JakubPajak/arduino_robot/report/report.tex

\documentclass{report}
\usepackage{tocloft}
\usepackage{geometry}
\usepackage{graphicx}
\usepackage{caption}
\usepackage[T1]{fontenc}
\usepackage[utf8]{inputenc}
\usepackage[polish]{babel}
\usepackage{float}
\usepackage{listings}
\usepackage{xcolor}
\usepackage{array}
\usepackage{enumitem}
\usepackage[style=alphabetic]{biblatex}
\usepackage{multirow}
\usepackage{hyperref}
\addbibresource{bibliography.bib}

\geometry{
    a4paper,
    left=2.5cm,
    right=2.5cm,
    top=2.5cm,
    bottom=2.5cm,
}

\lstset{
    language=Matlab, 
    basicstyle=\footnotesize\ttfamily,
    keywordstyle=\color{blue},
    commentstyle=\color{green},
    stringstyle=\color{red},
    numbers=left,
    numberstyle=\tiny\color{gray},
    stepnumber=1,
    numbersep=5pt,
    backgroundcolor=\color{lightgray},
    frame=single,
    tabsize=2,
    captionpos=b,
    breaklines=true
}

\setcounter{tocdepth}{3}
\setlength{\cftbeforechapskip}{15pt} 
\setlength{\cftbeforesecskip}{8pt} 
\setlength{\cftbeforesubsecskip}{5pt} 
\setlength{\cftbeforesubsubsecskip}{5pt}

\renewcommand\thesection{\arabic{section}.}
\renewcommand\thesubsection{\thesection\arabic{subsection}.}
\renewcommand\thesubsubsection{\thesubsection\arabic{subsubsection}.}
\setcounter{secnumdepth}{3}

\begin{document}

\begin{titlepage}
    \centering
    \vspace*{1cm}
    \begin{figure}
        \centering 
        
    \end{figure}
    \Huge
    Zajęcia Projektowe
    \par
    \textbf{Podstawy Robotyki}
    
    \vspace*{1cm}

    \vspace{0.5cm}
    \LARGE \textit{Platforma jeżdżąca automatycznie utrzymująca odległość od ściany}
    
    \vspace{1.5cm}
    
    \textbf{Autorzy:} 
    \par
    Jakub Pająk 
    \par
    Łukasz Grabarski
    \par 
    Krzysztof Grądek
    \par 
    Piotr Legień
    \par
    Bartosz Wuwer
    \vspace*{1.5cm}
    \par AiR Grupa 5TI
    
    \vfill
    
    \Large 30.05.2024
    
\end{titlepage}

\newpage

\tableofcontents

\newpage

\section{\LARGE Wprowadzenie}
\subsection{\Large Cel projektu}
Celem niniejszego projektu jest opracowanie mobilnej platformy robotycznej, zdolnej do automatycznego utrzymywania określonej odległości od ściany. Platforma ta bazować będzie na mikrokontrolerze Arduino oraz laserowych czujnikach odległości typu ToF (ang. Time of Flight). Projekt ma na celu zbadanie i rozwinięcie zaawansowanych algorytmów sterowania i nawigacji, które umożliwią precyzyjne śledzenie ścian w zmiennych warunkach środowiskowych. Dodatkowym celem jest stworzenie wszechstronnego rozwiązania, które można łatwo dostosować do różnych zastosowań, takich jak roboty sprzątające, inspekcyjne czy systemy autonomiczne w logistyce.

\subsection{\Large Założenia wstępne}
Robot został zaprojektowany w oparciu o mikrokontroler Arduino Uno R4, wybrany ze względu na wbudowany moduł Bluetooth LE (LE - Low Energy), co umożliwiło zdalne monitorowanie i kontrolę. Silniki zastosowane w projekcie są wyposażone w enkodery, co zapewni precyzyjne sterowanie. Czujniki odległości zostały podłączone do mikrokontrolera za pomocą magistrali I2C. Ze względu na planowaną liczbę czujników (osiem), połączenie ich innymi metodami nie byłoby możliwe.

Zasilanie platformy jest wystarczające do obsługi co najmniej jednego mikrokontrolera oraz czterech silników. Optymalnym rozwiązaniem jest zastosowanie czterech ogniw litowo-jonowych połączonych w konfiguracji 2S2P, co zapewni odpowiednią wydajność energetyczną. Dodatkowo, konieczne jest zastosowanie układu zarządzania baterią BMS (ang. Battery Management System), który zabezpieczy ogniwa przed nadmiernym rozładowaniem i przeładowaniem.

Całość konstrukcji została zamknięta w obudowie wykonanej techniką druku 3D. Obudowa jest podzielona na dwie główne sekcje: dolną, w której zostaną umieszczone silniki oraz ogniwa wraz z układem BMS, oraz górną, zawierającą płytkę stykową, mikrokontroler oraz czujniki. Taka konstrukcja zapewnia łatwy dostęp do kluczowych komponentów i umożliwi ich sprawną wymianę w razie potrzeby.

% Początkowo plan realizacji projektu zakładał stworzenie aplikacji, która byłaby odpowiedzialna za zdalne sterowanie robotem poprzez moduł BLE (ang. Bluetooth Low Energy). W wyniku późniejszych konsultacji plan uległ zmianie jednak aplikacja zostanie wykorzystana jako wsparcie dla automatycznego trybu robota.

\section{\LARGE Realizacja projektu}
Projekt był realizowany etapami, jednak nie został zastosowany szczegółowy harmonogram. 
Przybliżone etapy rozwoju projektu:
\begin{enumerate}
    \item Napisanie aplikacji w wersji dedykowanej systemowi Android w języku Dart,
    \item Realizacja prostego skryptu w Arduino IDE w celu weryfikacji połączenia BLE z mikrokontrolerem,
    \item Wykonanie projektu obudowy robota w 3D oraz przygotowanie do druku,
    \item Wykonanie prostego kodu w celu weryfikacji poprawności podłączenia silników do sterownika,
    \item Podłączenie oraz weryfikacja poprawności działania laserowych czujników odległości,
    \item Montaż silników wewnątrz dolnej komory obudowy,
    \item Montaż ogniw wraz z układem BMS,
    \item Integracja czujników z silnikami oraz implementacja logiki sterowania,
    \item Testy poprawności działania algorytmu sterującego.
\end{enumerate}

\subsection{\Large Panel sterowania w aplikacji}
Podczas analizy możliwych rozwiązań problemu zdalnego sterowania robotem wybór padł na wykonanie aplikacji mobilnej oraz przesyłanie odpowiednich komend za pomocą protokołu BLE. Protokół BLE jest pewnym szczególnym przypadkiem ogólnego protokołu Bluetooth, jest on szczególnie często spotykany w przypadku mniej zaawansowanych mikrokontrolerów takich jak Arduino Uno R4. Dzięki odpowiedniej architekturze protokół ten pozwala na bardziej efektywne zarządzanie pobieraną energią, jednocześnie zachowując niezbędne funkcjonalności. 

Przez wzgląd na wcześniej nabyte umiejętności tworzenia aplikacji za pomocą języka Dart przez jednego z członków sekcji, prace nad projektem rozpoczęto od implementacji podstawowej wersji aplikacji realizującej proste przesyłanie informacji w postaci całkowitoliczbowej w celu późniejszej interpretacji otrzymanych danych w środowisku Arduino. 

Przez wzgląd na tematykę projektu implementacja aplikacji nie zostanie w poniższym raporcie szczegółowo omówiona. Zostanie przedstawiony podstawowy interfejs graficzny oraz zasada działania kluczowych funkcji, takich jak połączenie lub realizacja przesyłu danych. Autor uważa, iż pewne wyszczególnienie części metod oraz zastosowanych bibliotek może pomóc niektórym osobom w prostszym znalezieniu informacji na temat poprawnie działającego połączenia z mikrokontrolerem Arduino poprzez Bluetooth.

\subsection{\large Interfejs użytkownika aplikacji }
% --------------------------------------------------------
% Autor: Jakub Pajak
%
% TODO: Opisać Interfejs użytkownika oraz co robią poszczególne funkcje, jak działa aplikacja na poziomie ideowym
%
% Status: 100%
% --------------------------------------------------------

Interfejs użytkownika został zaprojektowany w celu umożliwienia podstawowej kontroli nad robotem. Z tego względu, nie poświęcono mu znacznej ilości czasu na poprawę estetyki.

Po uruchomieniu aplikacji użytkownik trafia na ekran początkowy (ang. Home), przedstawiony na Rysunku \ref{fig:home_screen}. Ekran ten zawiera cztery wyróżnione obszary, każdy z których pełni określoną funkcję. Pierwsza sekcja ma na celu wprowadzenie nowego użytkownika w sposób bezpiecznego i poprawnego korzystania oraz sterowania robotem.

Druga sekcja prowadzi do ustawień wyglądu aplikacji, gdzie użytkownik może dostosować kolorystykę i inne elementy graficzne interfejsu.

\begin{figure}[H]
    \centering
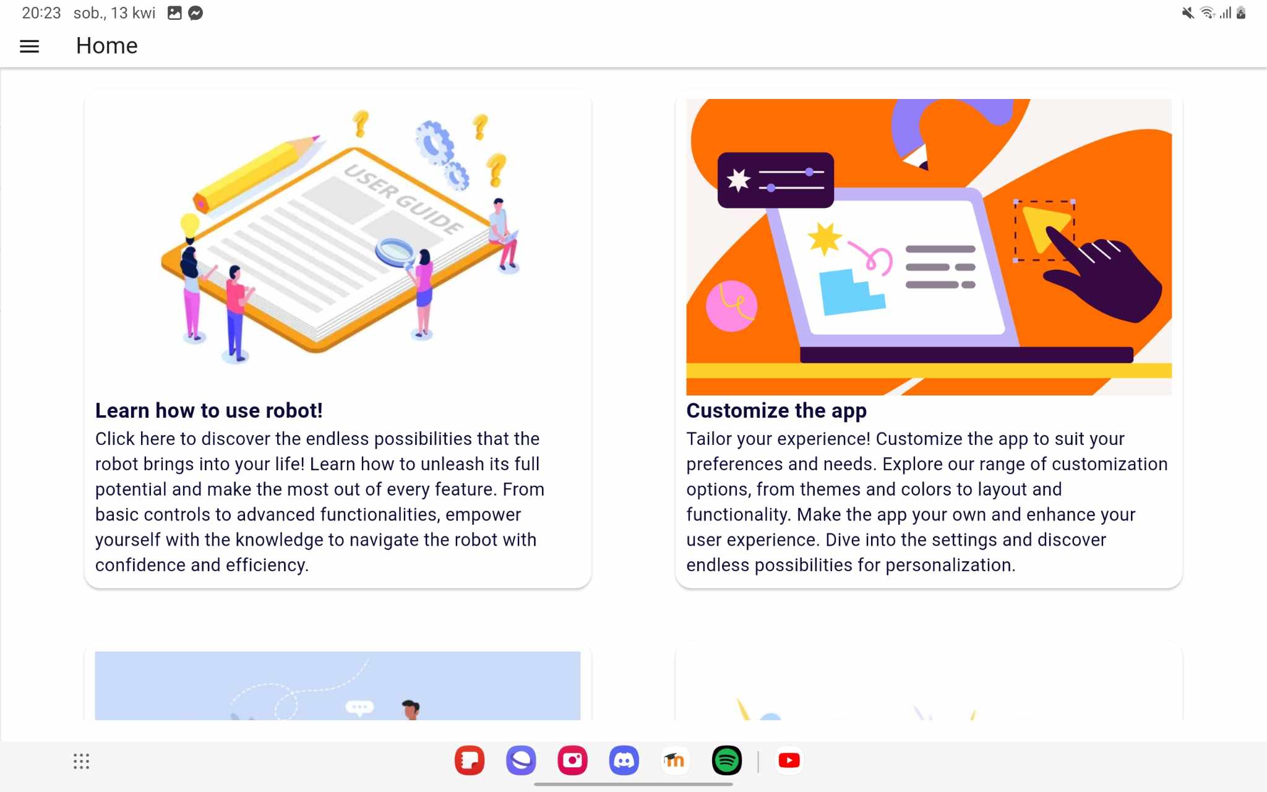
[picture p1: report/src/app/home.jpg]
    
    \caption{Ekran początkowy aplikacji}
    \label{fig:home_screen}
\end{figure}

Trzecia i czwarta sekcja dotyczą genezy projektu oraz zespołu, który stworzył robota i aplikację. Ponadto, umożliwiają one użytkownikom przesyłanie opinii, co pozwala na wprowadzenie przyszłych aktualizacji mających na celu poprawę jakości korzystania z aplikacji.

\begin{figure}[H]
    \centering
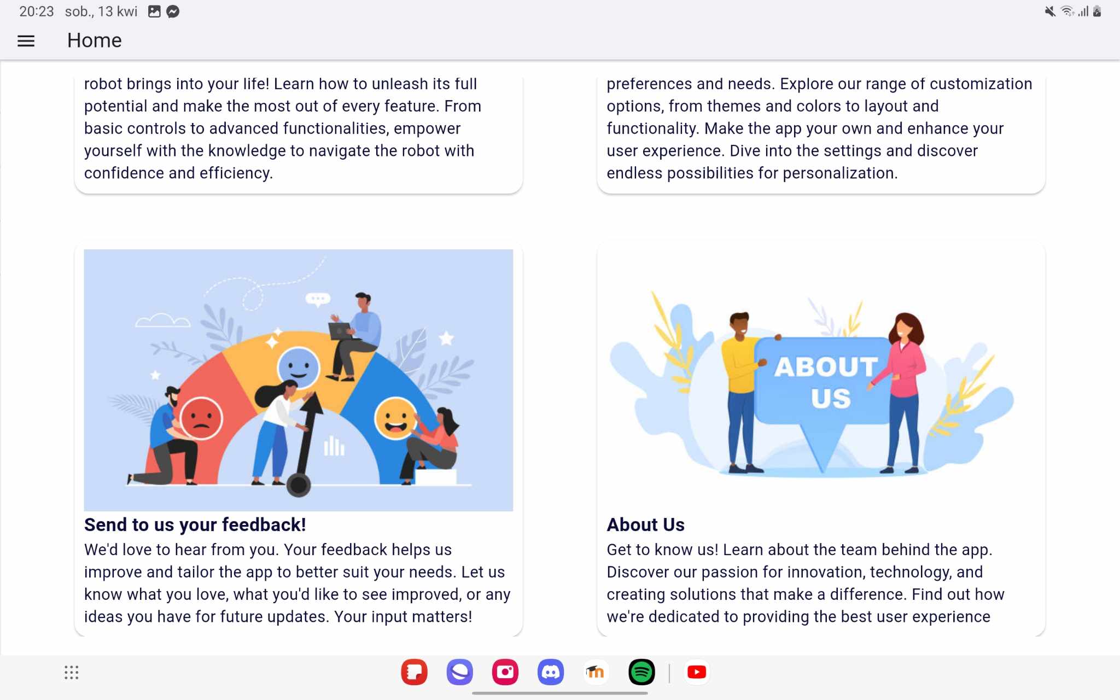
[picture p2: report/src/app/home-2.jpg]
    
    \caption{Obraz prezentujący ekran początkowy aplikacji}
    \label{fig:home_screen-2}
\end{figure}

W lewym górnym rogu ekranu znajduje się standardowy dla aplikacji mobilnych przycisk rozwijający menu boczne. Menu zawiera wszystkie niezbędne zakładki, takie jak:
\begin{itemize}
\item \textit{Control Panel} (Panel Kontrolny) – umożliwia sterowanie robotem,
\item \textit{Connect to device} (Połącz z urządzeniem) – pozwala na wyszukiwanie i łączenie z urządzeniem,
\item \textit{Settings} (Ustawienia) – umożliwia dostosowanie parametrów robota,
\item \textit{Help} (Pomoc) – zawiera informacje o korzystaniu z aplikacji oraz dane kontaktowe działu wsparcia.
\end{itemize}

\begin{figure}[H]
    \centering
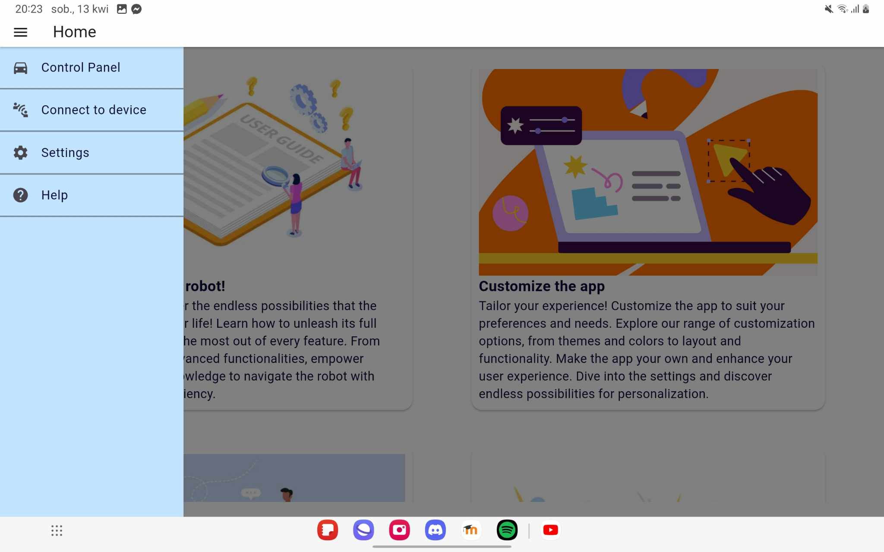
[picture p3: report/src/app/tab-control.jpg]
    
    \caption{Menu boczne aplikacji}
    \label{fig:side-menu}
\end{figure}

Po włączeniu pierwszej zakładki użytkownik zostaje przekierowany do strony odpowiedzialnej za sterowanie robotem. Ekran ten podzielony jest na dwie sekcje. Pierwsza z nich, zatytułowana \textit{Controls} (Kontrolki), umożliwia bezpośrednie sterowanie robotem poprzez odpowiednie przyciski. Po prawej stronie znajduje się sekcja, która w przyszłości ma wyświetlać animację przedstawiającą robota w ruchu.

\begin{figure}[H]
    \centering
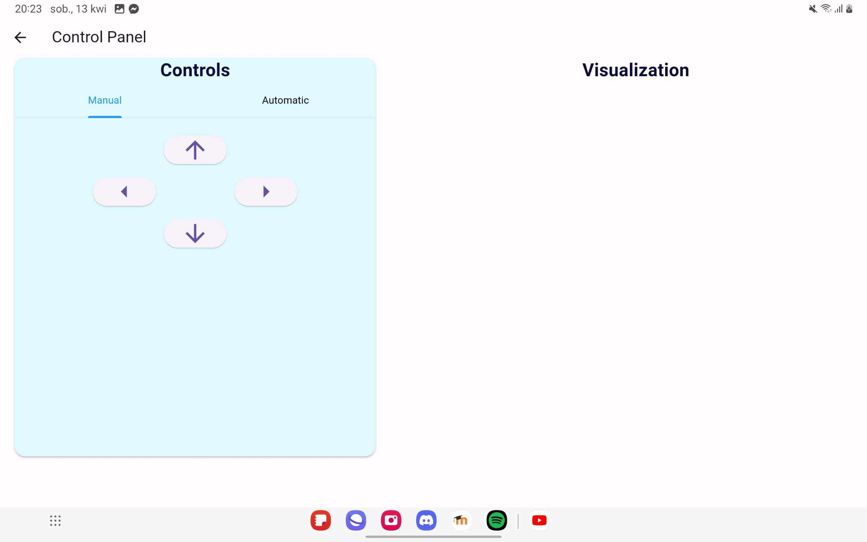
[picture p4: report/src/app/control.jpg]
    
    \caption{Ekran kontroli robota}
    \label{fig:control}
\end{figure}

Kolejną zakładką jest ekran wyświetlający dostępne urządzenia Bluetooth. Użytkownik może połączyć aplikację z wybranym urządzeniem poprzez naciśnięcie przycisku \textit{Connect} (Połącz). Zaleca się łączenie wyłącznie z urządzeniami będącymi częścią systemu robota.

\begin{figure}[H]
    \centering
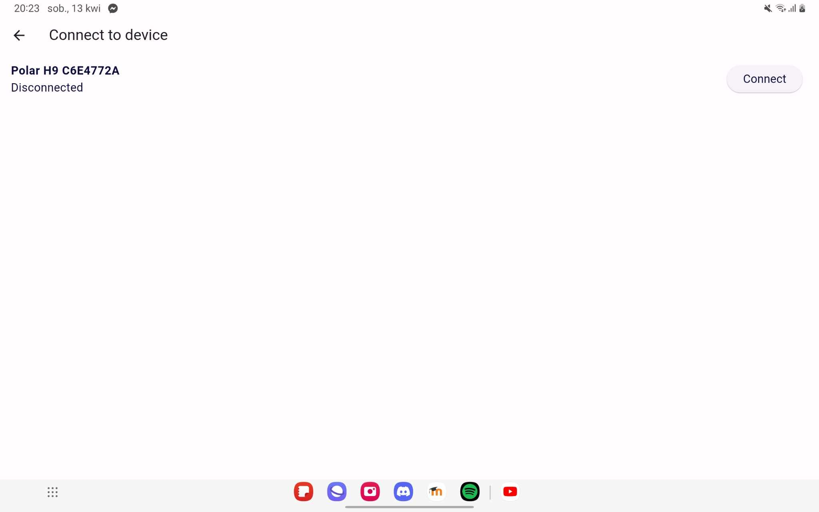
[picture p5: report/src/app/list-devices.jpg]
    
    \caption{Ekran połączenia z urządzeniami}
    \label{fig:Connect}
\end{figure}

Zakładki takie jak \textit{Settings} (Ustawienia) i \textit{Help} (Pomoc) nie zostały zaimplementowane z powodu zmiany priorytetów podczas rozwoju projektu. Niemniej jednak aplikacja ma duży potencjał rozwoju i może zostać rozbudowana w przyszłości.

\subsection{\Large Implementacja połączenia Bluetooth}
% --------------------------------------------------------
% Autor: Jakub Pajak
%
% TODO: Opisać zasadę działania połączenia Bluetooth poprzez paczkę flutter_blue
%
% Status: 100%
% --------------------------------------------------------

Kluczową informacją potrzebną do nawiązania połączenia z mikrokontrolerem Arduino UNO R4 jest fakt, iż mikrokontroler ten korzysta ze specyficznego rodzaju Bluetooth - Bluetooth Low Energy (BLE). W związku z tym konieczne było wykorzystanie odpowiedniej biblioteki, takiej jak \textit{flutter\_blue}. Bibliotekę tę można pobrać za pomocą narzędzia w terminalu, wpisując komendę:
\begin{verbatim}
flutter pub add flutter_blue
\end{verbatim}
Drugą istotną kwestią jest konieczność wykorzystania fizycznego urządzenia do uruchamiania aplikacji. Jest to zalecane ze względu na brak możliwości wyszukiwania urządzeń Bluetooth w niektórych emulatorach.

Pierwszym krokiem do nawiązania połączenia jest wyświetlenie listy wszystkich dostępnych urządzeń Bluetooth. W tym celu wykonywana jest funkcja \texttt{\_startScan()}, której zadaniem jest pobranie wszystkich dostępnych urządzeń i dodanie ich do listy w celu późniejszego wyświetlenia.

Funkcja \texttt{\_getPairedDevices()} zwraca wszystkie urządzenia, które zostały pomyślnie sparowane.

Po zakończeniu skanowania proces jest zamykany przy pomocy funkcji \texttt{\_stopScan()}.

\begin{figure}[H]
    \centering
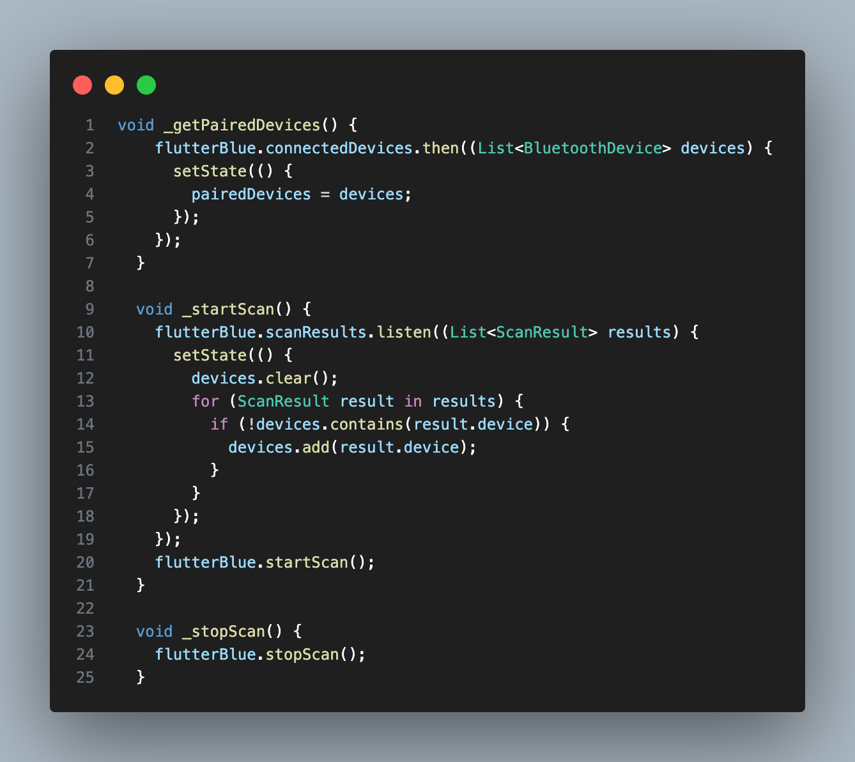
[picture p6: report/src/app/_getPairedDeviced.png]
    
    \caption{Fragment kodu źródłowego zawierający implementację wyszukiwania dostępnych urządzeń}
    \label{fig:con-list}
\end{figure}

Kolejnym krokiem jest nawiązanie połączenia z wybranym urządzeniem. Proces ten jest realizowany przez funkcję \texttt{\_connectToDevice()}, która jako parametr przyjmuje referencję do wybranego urządzenia z listy. Funkcja ta wywołuje metodę kończącą skanowanie, a następnie na instancji klasy \texttt{BluetoothDevice} wywołuje metodę \texttt{connect()}, która realizuje połączenie. Klasa \texttt{BluetoothDevice} jest dostępna dzięki użyciu biblioteki \texttt{flutter\_blue}.

\begin{figure}[H]
    \centering
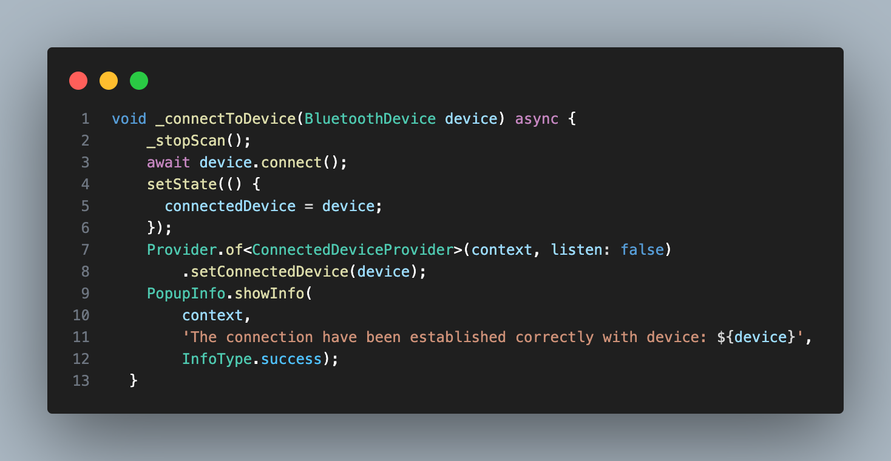
[picture p7: report/src/app/connect.png]
    
    \caption{Fragment kodu źródłowego zawierający implementację nawiązywania połączenia BLE}
    \label{fig:con-soft}
\end{figure}

\subsection{\Large Implementacja przesyłania danych}
% --------------------------------------------------------
% Autor: Jakub Pajak
%
% TODO: Opisać sposób przekazywania infomracji o przyciśniętym przycisku w postaci całkowitoliczbowej
%
% Status: 100%
% --------------------------------------------------------

Proces przesyłania informacji do urządzenia Bluetooth opiera się na metodzie \texttt{sendValueToArduino()}. Ta metoda przyjmuje dwa parametry: referencję do połączonego urządzenia oraz wartość, która ma zostać przesłana.

Pierwszym krokiem w tej metodzie jest weryfikacja, czy urządzenie zostało poprawnie połączone oraz, czy jest możliwe przesłanie danych. W przypadku niepowodzenia tej weryfikacji, w konsoli zostaje wyświetlona stosowna informacja diagnostyczna, co pozwala na szybkie zidentyfikowanie problemu.

Następnie metoda wyszukuje urządzenia o konkretnej charakterystyce, która jest niezbędna do prawidłowego funkcjonowania połączenia. Znalezienie urządzenia o odpowiedniej charakterystyce jest kluczowe, ponieważ zapewnia, że dane zostaną przesłane do właściwego odbiorcy.

Jeśli charakterystyka urządzenia zgadza się z oczekiwaną, wartość jest przesyłana. Taki proces zapewnia nie tylko prawidłowość przesyłania danych, ale również bezpieczeństwo połączenia.

Poniżej znajduje się fragment kodu źródłowego, który ilustruje implementację logiki przesyłania informacji do urządzenia.

\begin{figure}[H]
\centering
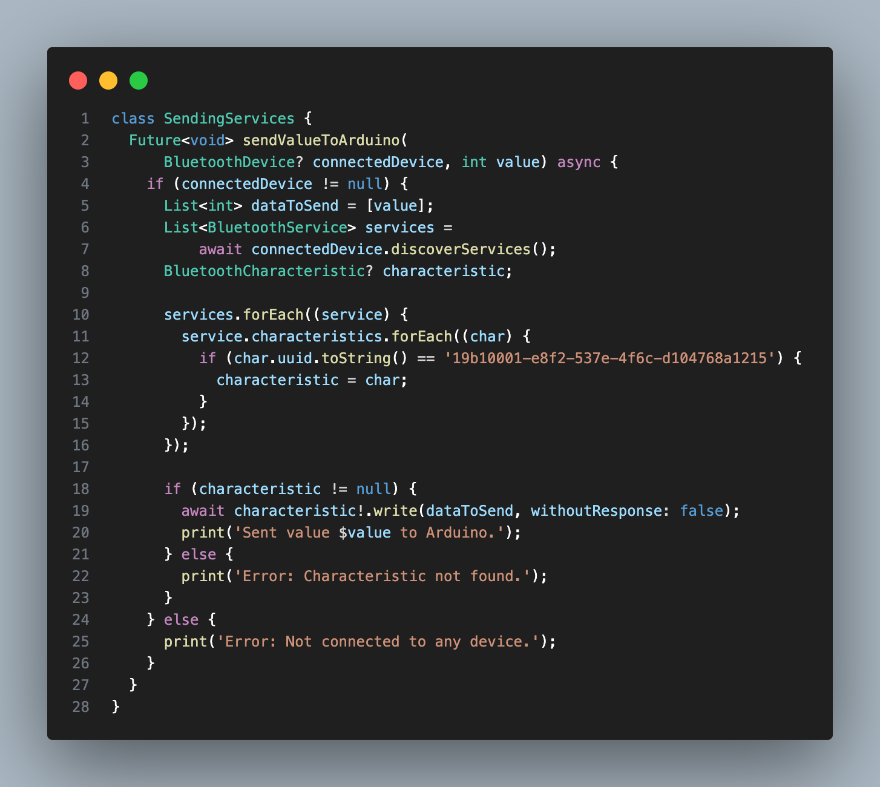
[picture p8: report/src/app/send.png]

\caption{Fragment kodu źródłowego zawierający implementację logiki przesyłania informacji do urządzenia}
\label{fig:send-val}
\end{figure}

\subsection{\Large Implementacja prostego skryptu w odczytującego dane z kanału BLE }
Fragment prezentowanego kodu rozpoczyna się od zadeklarowania zmiennych globalnych opisujących charakterystyki połączenia Bluetooth. Pierwsza charakterystyka określa identyfikator typu GUID serwisu, następna określa, na jaki identyfikator przesyłane są zdarzenia typu "request". Ostatnia wartość definiuje identyfikator, na jaki są przesyłane zdarzenia typu 'response". 
W przypadku aktualnej wersji aplikacji istotna jest tylko wartość identyfikująca serwis oraz zdarzenia typu request, ponieważ mikrokontroler nie zwraca żadnej informacji do aplikacji. W razie dalszego rozwoju projektu zostanie zaimplementowanie wyświetlanie diagnostyki robota, stanu naładowania baterii oraz stanu pracy silników. 

Funkcja \texttt{t5Callback()} ma za zadanie pobierać wartość, która aktualnie została przesłana do kanału Bluetooth z poziomu aplikacji. Argumenty wejściowe funkcji to urządzenie, z którym Arduino nawiązało połączenie, drugi argument to wcześniej wspomniany identyfikator zdarzenia "request".

Następnie wartość jest odczytywana z kanału za pomocą funkcji \texttt{readValue()}. Funkcja ta jest częścią biblioteki \texttt{ArduinoBLE.h}.

W funkcji \texttt{setup()} następuje inicjalizacja odpowiednich charakterystyk oraz za pomocą funkcji \newline \texttt{setEventHandler()} zostaje określona sytuacja, w której nastąpi wywołanie funkcji \texttt{t5Callback} oraz odczytanie danych z kanału. 

\begin{figure}[H]
    \centering
    
    \caption{Fragment kodu źródłowego przedstawiający implementację konfiguracji kanału Bluetooth na Arduino}
    \label{fig:bt_con_arduino}
\end{figure}

\newpage
\subsection{\Large Proces wykonywania projektu obudowy robota}
% --------------------------------------------------------
% Autor: Łukasz Grabarski
%
% TODO: Opisać proces oraz sposób wykonania projektu obudowy w 3D
%
% Status: 100%
% --------------------------------------------------------

Proces projektowania obudowy dla platformy jeżdżącej stanowił wieloetapowe zadanie, które wymagało dokładnego zaplanowania i licznych poprawek. Pierwsza faza obejmowała stworzenie prototypu, który miał na celu optymalne rozmieszczenie komponentów oraz weryfikację ich poprawnego działania. 
Ten etap pozwalał zidentyfikować ewentualne problemy konstrukcyjne i funkcjonalne na wczesnym etapie prac.

\begin{figure}[H]
    \centering
    
    \caption{Prototypowa konstrukcja mająca na celu sprawdzenie poprawności działania komponentów.}
    \label{fig:bt_con_arduino}
\end{figure}

Kolejnym krokiem było opracowanie specjalnej obudowy, zdolnej pomieścić wszystkie wymagane elementy, przy jednoczesnym zachowaniu odpowiedniej geometrii kół szwedzkich (zwanych również kołami Mecanum). 
Aby robot działał zgodnie z założeniami, koła musiały być rozmieszczone w orientacji X Y równych odstępach od siebie, a ich rolki powinny być skierowane do środka. Konieczne jest, aby z rzutu górnego posiadał przedłużenie osi kół w kształcie znaku X. 

\begin{figure}[H]
    \centering
    
    \caption{Plan rozmieszczenia kół szwedzkich. Kluczowe jest zachowanie kół w równych odstępach od siebie oraz utworzenie znaku X.}
    \label{fig:bt_con_arduino}
\end{figure}

\begin{figure}[H]
    \centering
    
    \caption{Pierwsza wersja projektu zamodelowana w programie Blender 4.1.}
    \label{fig:bt_con_arduino}
\end{figure}

Jednakże podczas pierwszego etapu projektu nastąpiły problemy logiczne i konstrukcyjne. Pierwotnie używany darmowy program Blender 4.1 okazał się niewystarczający ze względu na niezgodność formatów eksportu z wymaganiami dostępnej drukarki 3D. 
W związku z tym konieczne było przejście na bardziej zaawansowane narzędzie, jakim jest AutoDesk Fusion. To oprogramowanie pozwoliło na dokładniejsze zaprojektowanie modelu, uwzględniając specyfikację drukarki, która posiadała obszar roboczy o wymiarach 25 cm x 25 cm. 
Z tego powodu, model musiał zostać zaprojektowany od nowa, z uwzględnieniem ograniczeń.

\begin{figure}[H]
    \centering
    
    \caption{Wizualizacja gotowego modelu w programie AutoDesk Fusion.}
    \label{fig:bt_con_arduino}
\end{figure}

\newpage

Gotowy produkt składa się z dwóch pięter, z których każde pełni inną funkcję. 
Pierwsze piętro to "piętro maszynowe", gdzie umieszczone zostały moduły napędowe, takie jak silniki kątowe wraz z przekładnią oraz ogniwa zasilające w ilości dwóch wraz ze sterownikiem BMS. 
Wszystkie istotne kable zostały przeprowadzone przez specjalnie przygotowany otwór do drugiego piętra.

\begin{figure}[htbp]
    \centering
    \begin{minipage}[b]{0.45\textwidth}
        \centering
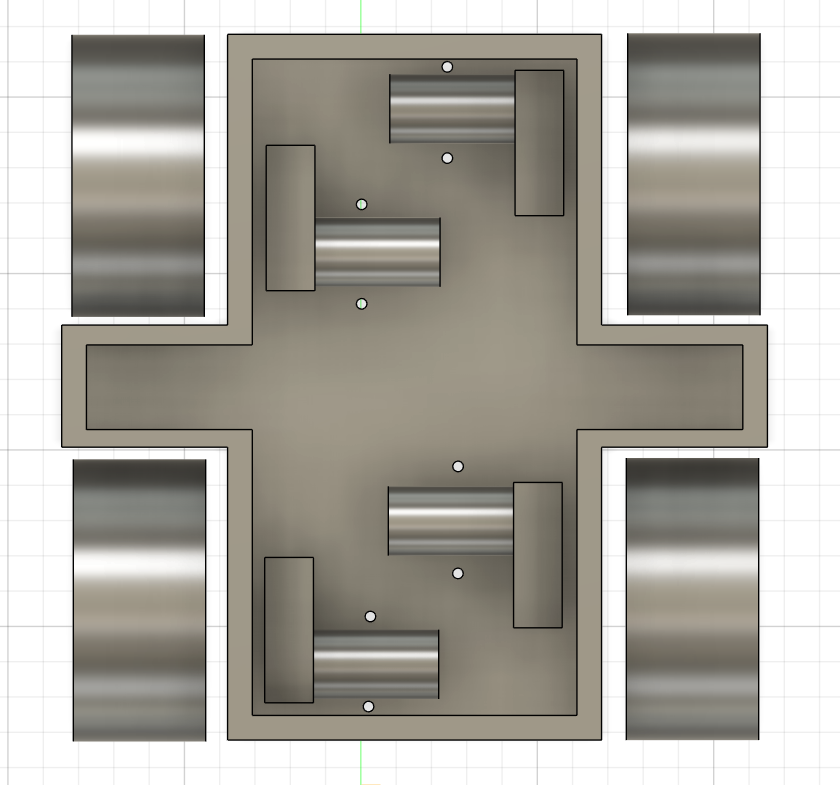
[picture p9: report/src/Robot_pics/Dol.png]
        
        \caption{Widok rzutu górnego na pierwsze piętro modelu. Znajdują się w nim silniki kątowe z przekładnią oraz miejsce na ogniwa zasilające wraz z BMS.}
        \label{fig:zdjecie1-robo}
    \end{minipage}
    \hfill
    \begin{minipage}[b]{0.45\textwidth}
        \centering
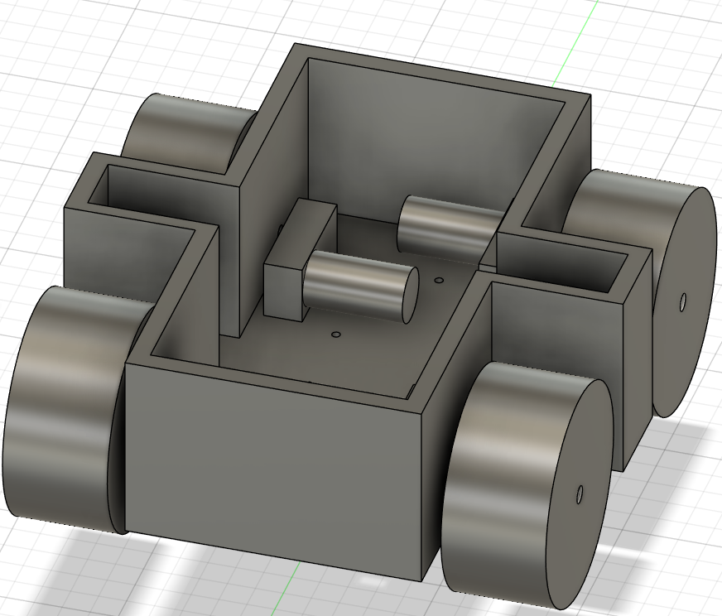
[picture p10: report/src/Robot_pics/Dol 1.png]
        
        \caption{Widok rzutu bocznego na pierwsze piętro modelu.}
        \label{fig:zdjecie2}
    \end{minipage}
\end{figure}

Drugie piętro to "mózg operacyjny" całego projektu. Zawiera ono kluczowe połączenia elektroniczne, w tym dwa mikrokontrolery Arduino UNO 4 i 3 w konfiguracji Master-Slave, oraz osiem czujników laserowych umieszczonych w przygotowanych otworach na ścianach bocznych. 
Takie rozmieszczenie i organizacja komponentów pozwalają na efektywne zarządzanie funkcjami robota.

\begin{figure}[htbp]
    \centering
    \begin{minipage}[b]{0.45\textwidth}
        \centering
        
        \caption{Widok rzutu górnego na drugie piętro modelu. Znajdują się w nim dwa mikrokontrolery Arduino UNO oraz płytka stykowa.}
        \label{fig:zdjecie1}
    \end{minipage}
    \hfill
    \begin{minipage}[b]{0.45\textwidth}
        \centering
        
        \caption{Widok rzutu bocznego na drugie piętro modelu.}
        \label{fig:zdjecie2}
    \end{minipage}
\end{figure}

\begin{figure}[H]
    \centering
    
    \caption{Widok rzutu bocznego na specjalnie przygotowane miejsca do wsunięcia czujników laserowych.}
    \label{fig:bt_con_arduino}
\end{figure}

\begin{figure}[H]
    \centering
    
    \caption{Gotowy model przesłany do wydruku. Został pozbawiony elementów stylistycznych takich jak koła, silniki kątowe, mikrokontrolerów Arduino UNO oraz czujników laserowych.} 
    \label{fig:bt_con_arduino}
\end{figure}

\newpage

Gotowy model zawiera się w wymiarach 20 cm x 20 cm x 15 cm oraz wykonuje wszystkie zadane ruchy zdolne do wykonania tylko przy pomocy
kół szwedzkich. Pojazd wykonuje jazdę w kierunku w przód i w tył oraz w lewo i w prawo, jak i obrót w miejscu.

\begin{figure}[H]
    \centering
    
    \caption{Gotowy model po złożeniu wszystkich elementów w całość.}
    \label{fig:bt_con_arduino}
\end{figure}

\subsection{\Large Implementacja prostego kodu weryfikującego prawidłowe podłączenie silników}

% --------------------------------------------------------
% Autor: Krzysztof Grądek
%
% TODO: Opisać kod oraz sposób podłączenia silników do sterownika + krótki opis sterownika
%
% Status: 100%
% --------------------------------------------------------

Do połączenia silników z Arduino wykorzystano nakładkę Iduino ST1138. Umożliwia ona sterowanie czterema silnikami prądu stałego, o poborze prądu do 600 mA i napięciu zasilania do 36 V. Nakładka jest zasilana dwoma ogniwami 18650.

Weryfikacja połączenia silników została wykonana przy użyciu skryptu zamieszczonego poniżej. Na początku skryptu dodane są biblioteki Wire i AFMotor. Biblioteka Wire jest wykorzystywana do połączenia obu modułów Arduino w konfiguracji master-slave, natomiast biblioteka AFMotor służy do sterowania silnikami z nakładki Iduino.

W następnych liniach zdefiniowane są: adres urządzenia slave oraz globalna wartość bezpiecznego dystansu, który jest potrzebny, aby w przypadku wystającego gzymsu, który mógłby ominąć czujniki, pojazd nie zahaczył o niego.

Dalsza część kodu zawiera wykorzystanie biblioteki AFMotor i przypisanie konkretnych silników do zmiennych.

W ostatniej części, czyli setup, znajduje się połączenie przez bibliotekę Wire, rozpoczęcie komunikacji z prędkością 9600 bitów na sekundę (Serial.begin(9600)) oraz ustawienie prędkości wszystkich silników.

Do weryfikacji działania silników można zakomentować pozostałe ustawienia setSpeed, tak aby pozostało tylko jedno i sprawdzić, który silnik jest uruchomiony.
\begin{figure}[H]
    \centering
    
    \caption{Fragment kodu źródłowego przedstawiający weryfikacje prawidłowego połączenia silników}
    \label{fig:eng_ste_arduino}
\end{figure}

\subsection{\Large Podłączenie oraz weryfikacja poprawności działania czujników laserowych}

% --------------------------------------------------------
% Autor: Jakub Pająk
%
% TODO: Opisać sposób podłączenia czujników oraz kod weryfikujący podłączenie
%
% Status: 100% done
% --------------------------------------------------------
We wczesnej fazie planowania zakładano wykorzystanie ultradźwiękowych czujników odległości. Pomysł ten okazał się nietrafiony ze względu na sposób przekazywania danych przez te czujniki. Każdy czujnik posiada dwa wyprowadzenia, co przy użyciu ośmiu czujników wymagałoby wykorzystania co najmniej 16 pinów Arduino.

Następnie analiza skupiła się na wykorzystaniu magistrali I2C, która umożliwia podłączenie dużej liczby czujników za pomocą niewielkiej liczby pinów. Kluczowym warunkiem jest poprawna komunikacja między czujnikiem a mikrokontrolerem.

Laserowe czujniki odległości VL530L0X okazały się trafnym wyborem ze względu na ich korzystny stosunek jakości do ceny. Pomiary odległości są wystarczająco dokładne, a biorąc pod uwagę charakter obiektu wykrywanego, wysoka precyzja nie jest wymagana.

Czujniki zostały podłączone zgodnie z przeznaczeniem poprzez magistralę I2C. Kluczową rolę w podłączaniu wielu identycznych czujników odegrało użycie dodatkowego pinu XSHUT oraz odpowiedniej sekwencji kodu, aby pomyślnie zmienić adres czujnika na magistrali I2C. 

Pierwszym krokiem jest ustawienie odpowiedniego pinu GPIO (ang. General Purpose Input/Output) Arduino, podłączonego do pinu XSHUT czujnika, w trybie OUTPUT. Następnie należy skorzystać z funkcji \texttt{setAddress()}, aby ustawić odpowiedni adres dla wybranego czujnika. Kolejnym krokiem jest przełączenie stanu pinu Arduino na INPUT oraz odczekanie 10 milisekund.

Wykonanie powyższej sekwencji gwarantuje poprawną zmianę adresu czujnika na magistrali I2C. Użycie samej funkcji \texttt{setAddress()} bez zastosowania pinu XSHUT nie zmieni adresu czujnika.

\begin{figure}[H]
    \centering
    
    \caption{Fragment kodu źródłowego przedstawiający sekwencję konieczną do zmiany adresu czujnika}
    \label{fig:sensor_init}
\end{figure}

\subsection{\Large Montaż silników wewnątrz dolnej komory obudowy}

% --------------------------------------------------------
% Autor: Piotr Legień && Krzysztof Grądek
%
% TODO: Opisać sposób montażu silników oraz usztywnienia wału silnika + montaż kół
%
% Status: 100%
% --------------------------------------------------------
Silniki zostały przymocowane do dolnej części pojazdu za pomocą taśmy aluminiowej. Po wykonaniu tego kroku przystąpiono do montażu kół na silnikach. Koła zostały zamontowane na wygwintowanej szprysze, która została przymocowana bezpośrednio do silników.

W celu wyeliminowania luzów na silnikach podjęto dodatkowe działania. Wycięto dwie listwy aluminiowe, które zamontowano w taki sposób, aby przez nie przechodziły szprychy. Dzięki zastosowaniu tych listew, luz na kołach został znacznie zminimalizowany, co zapewniło stabilność całej konstrukcji.

Wykonanie tych czynności pozwoliło na usztywnienie wału silnika i zapewniło solidne połączenie kół z silnikami.
\begin{figure}[H]
    \centering
    
    \caption{Listwa boczna usztywniająca mocowanie silnika i eliminująca luzy na kole.}
    \label{fig:listwa-kola}
\end{figure}

\newpage
\subsection{\Large Montaż ogniw wraz z układem BMS}

% --------------------------------------------------------
% Autor: Bartosz Wuwer && Piotr Legień
%
% TODO: Opisać sposób połączenia ogniw oraz układ BMS (po co jest etc.)
%
% Status: 100%
% --------------------------------------------------------

Wszystkie uprzednie kroki realizacji projektu były wykonywane przy prowizorycznym zasilaniu przez cztery baterie alkaliczne połączone szeregowo. Tego typu zasilanie posiada szereg problemów, które utrudniałyby użytkowanie robota, a także nie zostało zgłębione pod względem efektywności. W związku z tym następnym krokiem do stworzenia w pełni funkcjonalnego robota AGV jest analiza zapotrzebowania energetycznego i potencjalnych źródeł energii.

\subsubsection{\large Obliczanie parametrów zasilania}

Robot AGV korzysta z czterech silników kątowych z przekładnią SJ02. Każdy silnik sterowany jest z nakładki na zestaw Arduino L293D Motor Driver Board. Moduł ten pozwala na regulowanie prędkości obrotowej i kierunku czterech silników prądu stałego o prądzie do $I_n=600 mA$ i napięciu do $U_n=36 V$. Zasilanie silników zaleca się poprowadzić przez kanał odseparowany od linii zasilania z USB. Sam moduł musi być zasilany napięciem 4,5 do 16 V, w przypadku napięcia wyższego niż 12 V, zaleca się zasilać osobno moduł i Arduino zdejmując zworkę PWR\_IMP. Specyfikację L293D Motor Driver Board przedstawiono na Rysunku \ref{fig:motor-driver-spec}.

\begin{figure}[H]
    \centering
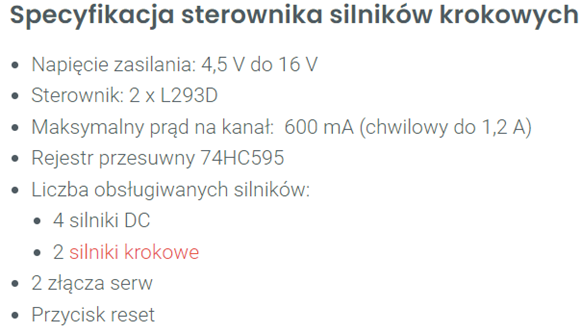
[picture p11: report/src/tech_specifications/L293D Motor Driver Board.png]
    
    \caption{Specyfikacja modułu L293D Motor Driver Board. \cite{MotorDriver}}
    \label{fig:motor-driver-spec}
\end{figure}

Silniki prądu stałego posiadają następującą specyfikację (Rys. \ref{fig:motor-spec}). Silnik na biegu jałowym 
pobiera prąd od $I_{o_{min}}=140 mA$ do $I_{o_{max}}=170 mA$, a podczas zwarcia (unieruchomiony wał) może płynąć maksymalnie prąd $I_{stall}=2,8 A$.

\begin{figure}[H]
    \centering
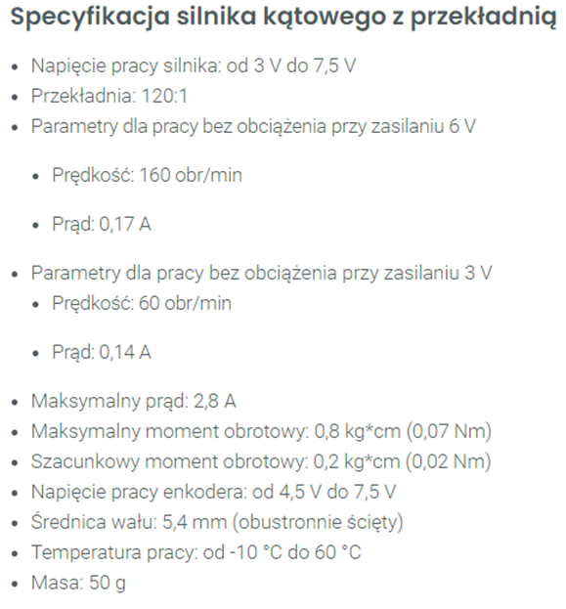
[picture p12: report/src/tech_specifications/TT Geared Motor with Encoder.png]
    
    \caption{Specyfikacja silnika TT Geared Motor with Encoder. \cite{MotorEngine}}
    \label{fig:motor-spec}
\end{figure}

Zasilanie silników powinno w związku z tym posiadać napięcie jednego silnika $U=3\ldots7,5 V$ i sumę 
prądów znamionowych każdego silnika czyli $I=560\ldots680 mA$, a także posiadać gotowość na pobór 
maksymalnego prądu zwarciowego, w przypadku zatrzymania wszystkich kół robota $I_{stall}=11,2 A$, 
wartości te umieszczono w tabeli (Tab. \ref{tab:motors-power}). Dodatkowo, warto zadbać o maksymalnie dużą pojemność, by robot mógł działać jak najdłużej.

\begin{table}[H]
\centering
    \begin{tabular}{|m{10em}|cc|}
    \hline
    Specyfikacja zasilania silników prądu stałego & \multicolumn{1}{c|}{Wartość min} & Wartość max \\ \hline
    U{[}V{]}                                      & \multicolumn{1}{c|}{3}           & 7,5         \\ \hline
    I {[}mA{]}                                    & \multicolumn{1}{c|}{560}         & 680         \\ \hline
    $I_{stall}$                                   & \multicolumn{2}{c|}{11200}                     \\ \hline
    \end{tabular}
    \caption{Wymagane wartości zasilania silników.}
    \label{tab:motors-power}
\end{table}

Arduino i moduł sterujący silnikami mogą być wspólnie zasilane dowolnym pakietem ogniw o napięciu $U_{ster}=4,5\ldots12 V$. Komfortowym rozwiązaniem może okazać się użycie powerbanka, jako że posiada on wbudowane wejście na kabel USB, które pozwala na łatwe połączenie.

\newpage
\subsubsection{Dobór zasilania}

Robot musi być zasilany przez baterie, żeby mógł być w pełni mobilny. Znając wymagania zasilania, należy 
teraz rozpatrzyć możliwe typy ogniw i ich połączenia. Połączenie równoległe ogniw sumuje pojemność i 
obciążalność pakietu $I_{równoległe}=I_1+I_2+I_3+\ldots$, a połączenie szeregowe napięcie 
$U_{szeregowe}=U_1+U_2+U_3+\ldots$. Pakiety te oznacza się nomenklaturą XSYP, gdzie X to liczba ogniw 
połączonych szeregowo, a Y ilość ogniw połączonych równolegle dla każdej baterii w szeregu, np. 3S2P 
oznacza pakiet 6 ogniw, 3 połączone szeregowo i 2 równolegle dla każdej baterii w szeregu.

Pakiet powinien mieć wypadkowe napięcie $U=3\ldots7,5 V$, a także być gotowy na pobór prądu zwarciowego $I_{stall}=11,2 A$ w przypadku zaklinowania wszystkich kół robota. W związku z tym moc zasilania powinna wynosić $P=33,6\ldots67,2 W$.

\begin{enumerate}[label=(\Alph*)]
    \item \textbf{Baterie alkaliczne}

    Ten rodzaj baterii charakteryzuje się jednorazowością, wykorzystując roztwór alkaliczny jako elektrolit. Napięcie ogniwa zwyczajowo wynosi 1,5 V. Ich dużą zaletą jest dostępność i niska cena.
    
    Producenci baterii nie podają pojemności, jako że zależy ona w dużej mierze od warunków, w których bateria pracuje, ale można założyć, że dobre ogniwo alkaliczne typu AA powinno mieć maksymalnie do 2300 mAh. Brakuje także bezpośrednich informacji o maksymalnym prądzie obciążenia, producenci zazwyczaj testują spadek napięcia dla maksymalnie prądu 1 A. Najprawdopodobniej bateria tego typu były by wstanie zostać obciążone większym prądem, jednakże patrząc na pojemność widzimy, że czas działania robota spadł by gwałtownie.
    
    Ogniwa tego typu nie są odpowiednie dla zastosowania w robocie, by uzyskać potrzebne napięcie trzeba połączyć dwie baterie szeregowo (2S), jednak z powodu niskiej prędkości obrotowej i spadku napięcia, które następuje gwałtowniej wraz z dużym poborem prądu (Rys. \ref{fig:duracell}), należy zastosować 3S lub 4S by uzyskać odpowiedni woltaż.
    
    \begin{figure}[H]
        \centering
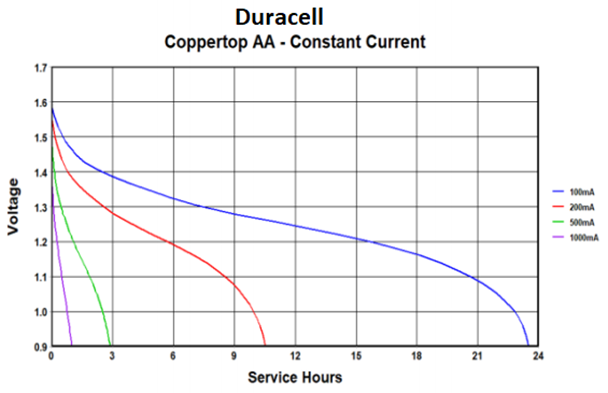
[picture p13: report/src/cells_charts/Duracell discharge.png]
        
        \caption{Wykres spadku napięcia do czasu pracy dla prądów ogniwa Duracell. \cite{DuracellChart}}
        \label{fig:duracell}
    \end{figure}

    Następnym problemem jest jednorazowość ogniw, jeśli wypadkowa pojemność będzie zbyt mała to używanie ich szybko przestanie być opłacalne. Należy także zwrócić uwagę na to, by wypadkowe napięcie nie spadło poniżej 3 V, czyli dla pakietu 3 baterii szeregowych (3S) 1 V na każdej baterii, a dla 4 ogniw szeregowych (4S) 0,75 V. Z wykresu spadków napięć (Rys. \ref{fig:duracell}) widać, że dla prądu 1 A, czas ten nie przekracza nawet 1,5 godziny. Nawet z zgrubnych obliczeń, przyjmując, że prąd obciążenia jednego silnika wynosi 600 mA, pobór prądu robota będzie wynosił 2,4 A. By ograniczyć pobór prądu na jednym pakiecie ogniw szeregowych do wartości wartych uwagi, należy połączyć je równolegle pięciokrotnie (5P), robot będzie wtedy wstanie pracować w układzie 3-szeregowym (3S5P) przez około 2 godziny i 45 minut, w układzie 4-szeregowym (4S5P) czas ten wydłuży się w przybliżeniu do niecałych 3 godzin (należy jednak pamiętać, że z wzrostem napięcia zasilania silniki pobierają większy prąd, co może skrócić te szacowanie [Rys. \ref{fig:motor-spec}]). W przypadku zwarcia silnika, baterie te zostaną gwałtownie rozładowane i czas pracy robota znacząco spadnie. 
    
    Praca robota nie przekracza trzech godzin, a żeby osiągnąć taki wynik trzeba użyć 15 do 20 baterii. Podsumowując krótko, użycie ogniw alkalicznych jest nieopłacalne.

    \item \textbf{Akumulatory litowo-jonowe (Li-Ion)}

    Ogniwa te można ładować, rolę elektrolitu pełnią w nich sole litowe. Napięcie znamionowe wynosi 3,6 V. Ich zaletą jest duża gęstość energii. Ogniwa te nie mogą zostać nadmiernie naładowane, ani rozładowane, w związku z tym potrzebują układu BMS (ang. Battery Management System). Stosunkowo duża cena wymusza budowanie mniejszych pakietów, jednakże możliwość ładowania ogniw znacznie zwiększa funkcjonalność nawet dla krótszego czasu pracy robota.
    
    Ze względu na dostępność, do obliczeń posłużono się ogniwem 18650 Li-ion Samsung INR18650-25R 2500mAh 20A (Rys. \ref{fig:spec-18650}). Ogniwo te ma przystępną cenę, wysoką pojemność i przede wszystkim wysoki maksymalny prąd rozładowania, daje to pewność, że w przypadku awarii i zwarcia wszystkich silników nie dojdzie do uszkodzenia baterii i potencjalnego pożaru.

    \begin{figure}[H]
        \centering
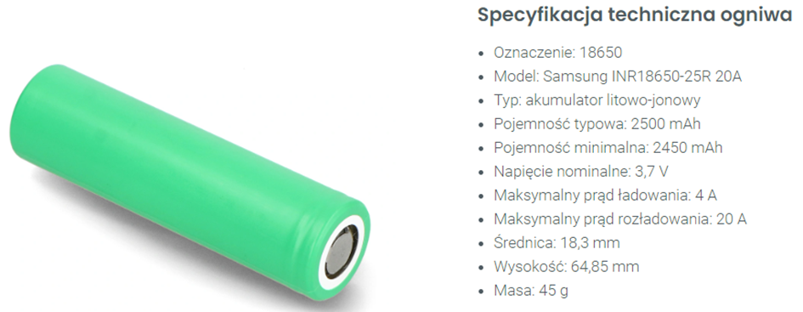
[picture p14: report/src/tech_specifications/Li-ion Samsung INR18650-25R .png]
        
        \caption{Specyfikacja ogniwa18650 Li-ion Samsung INR18650-25R \cite{18650Spec}.}
        \label{fig:spec-18650}
    \end{figure}

    Zgodnie z specyfikacją producenta nie należy ładować ogniwa powyżej napięcia $4,20 \pm 0,05$ V, a także nie należy rozładowywać go do wartości poniżej 2,5 V \cite{18650Charts}. W przypadku użycia ogniw jako zasilania robota AGV, nie należy doprowadzić do obniżenia napięcia wypadkowego poniżej 3 V.
    
    Napięcie znamionowe akumulatora Li-Ion wynosi 3,7 V, jest to wystarczająca wartość by zasilić robota w granicach dolnego napięcia zasilania. W związku z tym nie jest konieczne by łączyć więcej ogniw w szereg, jednak należy zwrócić uwagę na wykres spadku napięcia (Rys. \ref{fig:18650-h}, Rys. \ref{fig:18650-m}).

    \begin{figure}[H]
        \centering
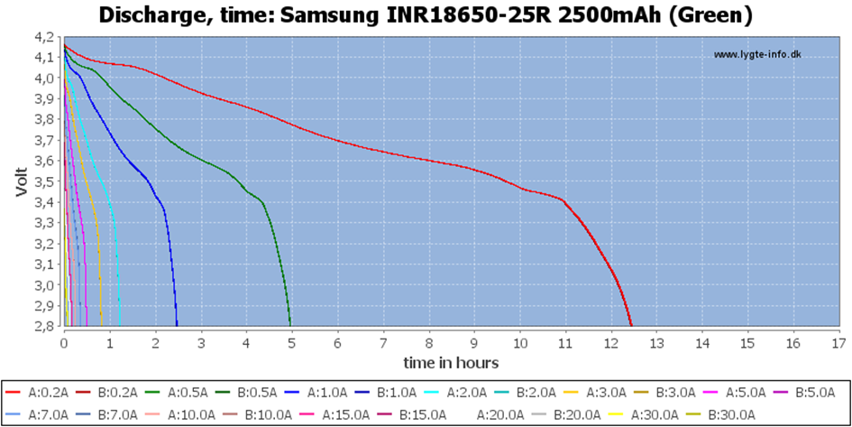
[picture p15: report/src/cells_charts/Li-ion discharge hours.png]
        
        \caption{Wykres spadku napięcia w czasie dla prądów obciążenia ogniwa INR18650-25R w godzinach. \cite{18650Charts}}
        \label{fig:18650-h}
    \end{figure}

    \begin{figure}[H]
        \centering
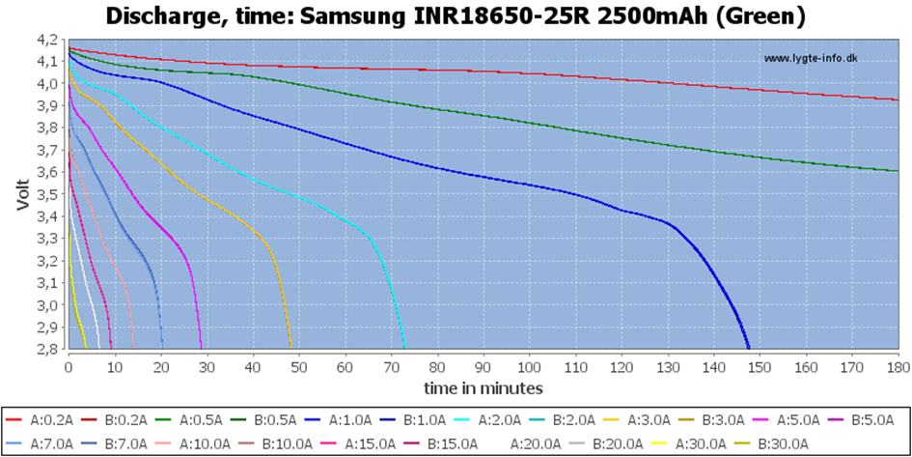
[picture p16: report/src/cells_charts/Li-ion discharge minutes.png]
        
        \caption{Wykres spadku napięcia w czasie dla prądów obciążenia ogniwa INR18650-25R w minutach. \cite{18650Charts}}
        \label{fig:18650-m}
    \end{figure}

    Dla prądu obciążenia wysokości 3 A, który można uznać za przybliżony prąd pracy w obciążeniu, dla 4 silników robota, czas rozładowania pojedynczego akumulatora od pełnego naładowania do 3 V wynosi około 47 minut. Jest to znacznie lepszy czas w porównaniu z bateriami alkalicznymi, zwłaszcza, że ogniwo po ponownym naładowaniu zachowuje zbliżone zależności napięcia do czasu (na rysunku \ref{fig:18650-h} i \ref{fig:18650-m} wykres B:2.0A pokrywa się z pierwszym rozładowaniem A:2.0A).
    
    Połączenie ogniw równolegle pozwala ograniczyć prąd obciążenia na pojedynczym akumulatorze, wydłużając jednocześnie pracę robota. W teorii użycie BMS 1S pozwoli kontrolować tego typu pakiet, jeśli wybrany BMS odłączy ogniwa przy napięciu 3 V. 
    
    Problematycznym jest fakt pracy silników na granicznym napięciu zasilania. Silniki stracą znacząco swoją prędkość obrotową, pogłębiając owy problem wraz z dłuższą pracą robota. Wyniki czasów pracy zapisano w tabeli (Tab. \ref{tab:cells-times-from-chart}), za wyjściowy prąd obciążenia uznano 3 A, a czasy sczytano z wykresów spadków napięć (Rys. \ref{fig:18650-h}, Rys. \ref{fig:18650-m}), dla wartości pośrednich wyznaczono wartość średnią. Obliczono także czas pracy z pojemności typowej (Tab. \ref{tab:cells-times-from-capacity}).

    \begin{table}[H]
        \centering
        \begin{tabular}{|c|c|cc|}
        \hline
        \multirow{2}{*}{\begin{tabular}[c]{@{}c@{}}Układ \\ pakietu\end{tabular}} & \multirow{2}{*}{\begin{tabular}[c]{@{}c@{}}Prąd obciążenia\\ na pojedyncze \\ ogniwo {[}A{]}\end{tabular}} & \multicolumn{2}{c|}{\begin{tabular}[c]{@{}c@{}}Przybliżony czas pracy\\ od 4,2 V do 3 V dla \\ charakterystyk spadków \\ napięć\end{tabular}} \\ \cline{3-4} 
                                                                                &                                                                                                            & \multicolumn{1}{c|}{{[}min{]}}                                                    & {[}h{]}                                                   \\ \hline
        1P                                                                        & 3                                                                                                          & \multicolumn{1}{c|}{47}                                                           & 0,73                                                      \\ \hline
        2P                                                                        & 1,50                                                                                                       & \multicolumn{1}{c|}{108}                                                          & 1,80                                                      \\ \hline
        3P                                                                        & 1                                                                                                          & \multicolumn{1}{c|}{144}                                                          & 2,40                                                      \\ \hline
        4P                                                                        & 0,75                                                                                                       & \multicolumn{1}{c|}{216}                                                          & 3,60                                                      \\ \hline
        \end{tabular}
        \caption{Przybliżony czas pracy pakietu ogniw względem wykresów spadków napięć.}
        \label{tab:cells-times-from-chart}
    \end{table}

    \begin{table}[H]
        \centering
        \begin{tabular}{|c|c|cc|}
        \hline
        \multirow{2}{*}{\begin{tabular}[c]{@{}c@{}}Układ \\ pakietu\end{tabular}} & \multirow{2}{*}{\begin{tabular}[c]{@{}c@{}}Prąd obciążenia\\ na pojedyncze \\ ogniwo {[}A{]}\end{tabular}} & \multicolumn{2}{c|}{\begin{tabular}[c]{@{}c@{}}Przybliżony czas pracy\\ od 4,2 V do 3 V dla \\ typowych pojemności\end{tabular}} \\ \cline{3-4} 
                                                                                &                                                                                                            & \multicolumn{1}{c|}{{[}min{]}}                                                    & {[}h{]}                                                   \\ \hline
        1P                                                                        & 3                                                                                                          & \multicolumn{1}{c|}{50}                                                           & 0,83                                                      \\ \hline
        2P                                                                        & 1,50                                                                                                       & \multicolumn{1}{c|}{100}                                                          & 1,67                                                      \\ \hline
        3P                                                                        & 1                                                                                                          & \multicolumn{1}{c|}{150}                                                          & 2,50                                                      \\ \hline
        4P                                                                        & 0,75                                                                                                       & \multicolumn{1}{c|}{200}                                                          & 3,33                                                      \\ \hline
        \end{tabular}
        \caption{Czas pracy pakietu ogniw obliczony z typowej pojemności.}
        \label{tab:cells-times-from-capacity}
    \end{table}

    W celu zwiększenia prędkości obrotowej silników, można użyć pakietów dwóch ogniw szeregowych. Napięcie wypadkowe będzie wynosić wtedy 7,4 V.
    
    W przypadku większego napięcia zwiększy się pobór prądu i czas pracy w pewnym stopniu się zmniejszy, ciężko oszacować teoretycznie tą różnice, ale można założyć że nie będzie ona znacząca. Zaletą takiego połączenia jest zdecydowanie większa stabilność działania robota. Nawet gdy ogniwa rozładują się do momentu 2,5 V, który niektórzy producenci BMS podają jako graniczne napięcie odcięcia, napięcie wypadkowe wynosić będzie 5 V. Tak wysokie napięcie pozwala na pracę silników w odpowiedniej prędkości, oznacza to, że przez cały czas pracy robota silniki nie stracą znacząco swoją efektywność.
    
    Podsumowując, ogniwa Li-Ion nadają się idealnie jako zasilanie robota AGV, zwłaszcza biorąc pod uwagę potencjalnie wysoki prąd zwarciowy silników, który z sporym zapasem owe ogniwa są wstanie dostarczyć. Przez kwestie finansowe ograniczono ilość możliwych do użycia ogniw do 4, w związku z tym najlepszym rozwiązaniem jest użycie pakietu 2S2P maksymalizując prędkość obrotową i czas pracy.

    Ostatecznie użyto pakiet 2S, który także jest wystarczający do zasilania. Zestaw Arduino oraz nakładkę zasilono przy pomocy powerbanka, w związku na łatwość połączenia.
    \end{enumerate}

\subsubsection{Dobór układu BMS}

W celu zabezpieczenia układu należy użyć układ BMS, który będzie zabezpieczał przed nadmiernym rozładowaniem akumulatorów Li-Ion oraz nadmiernym naładowaniem. Dodatkowo BMS zabezpiecza przed zbyt dużym poborem prądu. W przypadku owego projektu, prąd rozruchowy silników może być bliski prądu zwarciowemu czterech silników, czyli 11,2 A. Zastosowano BMS o następujących specyfikacjach (Rys. \ref{fig:spec-BMS}).

\begin{figure}[H]
    \centering
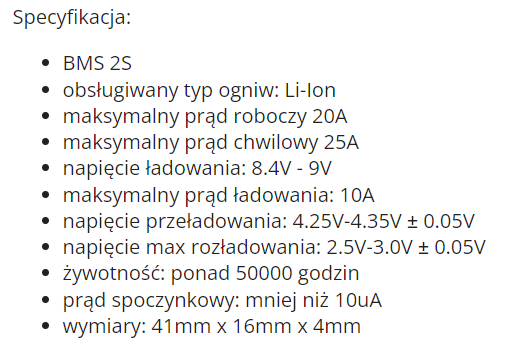
[picture p17: report/src/tech_specifications/BMS 2S 20A 8.4V.png]
    
    \caption{Specyfikacja modułu BMS 2S 20A 8,4V \cite{BMSSpec}.}
    \label{fig:spec-BMS}
\end{figure}

By moduł BMS poprawnie kontrolował stan ogniw, należy go podłączyć w następujący sposób dla pakietu 2S (Rys. \ref{fig:BMS-2S-schematic}) oraz alternatywny pakietu 2S2P (Rys. \ref{fig:BMS-2S2P-schematic}). Wyjścia "0V", "4,2V" i "8,4V" z modułu BMS zostały przylutowane do koszyczków ogniw 18650, a wyjścia "$+$" i "$-$" wychodzą na zasilanie nakładki L293D Motor Driver Board.

\begin{figure}[H]
    \centering
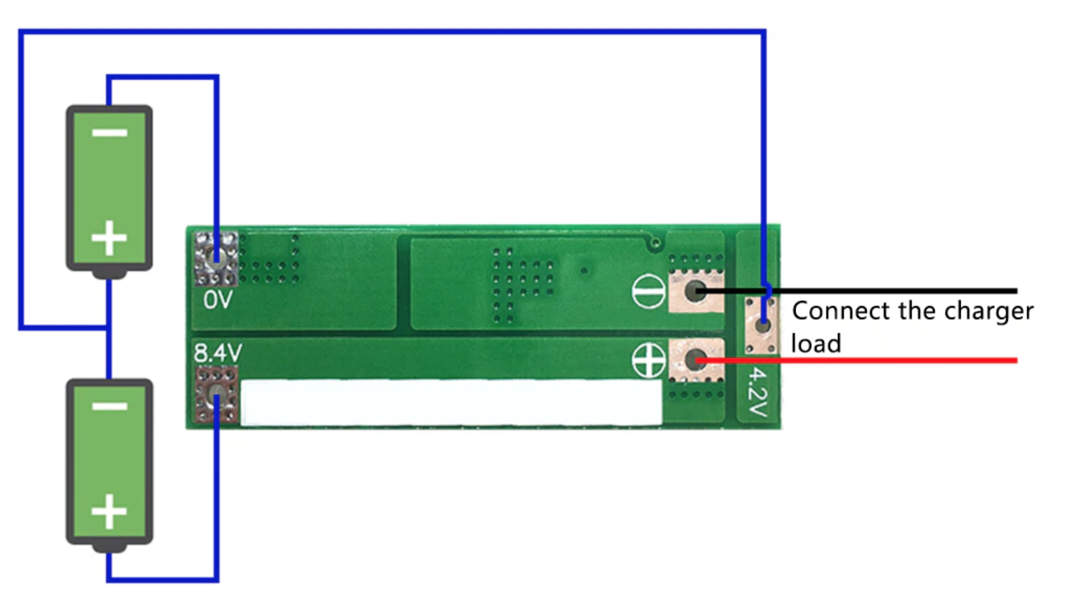
[picture p18: report/src/cells_charts/BMS 2S schematic.png]
    
    \caption{Układ podłączenie ogniw z modułem BMS w pakiecie 2S \cite{BMSSchematic}.}
    \label{fig:BMS-2S-schematic}
\end{figure}

\begin{figure}[H]
    \centering
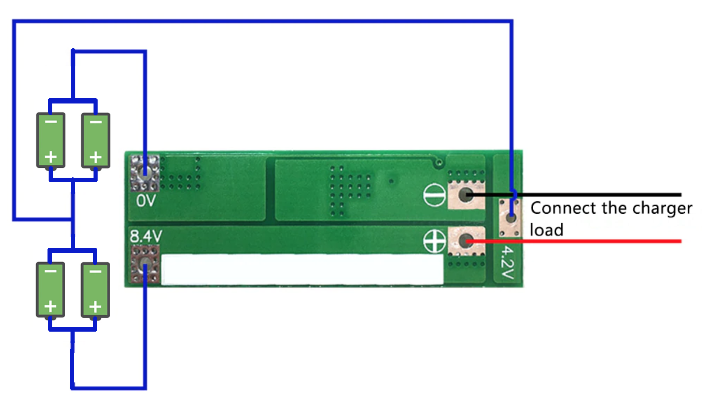
[picture p19: report/src/cells_charts/BMS 2S2P schematic.png]
    
    \caption{Układ podłączenie ogniw z modułem BMS w pakiecie 2S2P.}
    \label{fig:BMS-2S2P-schematic}
\end{figure}

\newpage
\subsection{\Large Integracja czujników z silnikami oraz implementacja logiki sterowania}
% --------------------------------------------------------
% Autor: Jakub Pająk && Łukasz Grabarski
%
% TODO: Opisać kod implementujący integrację czujników z silnikami
%
% Status: Łukasz 50% (jeszcze coś dopiszę) || Jakub - 100%
% --------------------------------------------------------

W celu osiągnięcia optymalnej integracji modułu czujników oraz modułu sterowania silnikami zastosowano strukturę opartą na magistrali I2C. W omawianym układzie wykorzystano architekturę typu Master-Slave. Moduł odczytu danych z czujników oraz moduł odpowiedzialny za sterowanie silnikami są realizowane przez dwa oddzielne mikrokontrolery Arduino UNO. Mikrokontroler odpowiedzialny za odczyt wartości z czujników pełni rolę Master, przetwarzając informacje uzyskane z czujników i na ich podstawie przesyłając sygnały sterujące do mikrokontrolera pełniącego rolę Slave.

Zastosowanie tej specyficznej architektury było niezbędne z uwagi na ograniczenia w dostępności pinów GPIO. Wykorzystanie czterokanałowego sterownika silników w formie nakładki na mikrokontroler Arduino spowodowało zmniejszenie liczby dostępnych pinów do pinów analogowych o adresach od A0 do A5. Jak wspomniano w sekcji 2.8, wykorzystanie kilku czujników wymaga dostosowania ich adresów. W związku z tym konieczne było uzyskanie dostępu do co najmniej siedmiu pinów ogólnego przeznaczenia I/O, co zapewnia drugie Arduino pełniące rolę Master.

\subsubsection{\large Master}

Kod źródłowy rozpoczyna się od deklaracji oraz inicjalizacji zmiennych oraz stałych globalnych. Są to między innymi adresy czujników, typ wyliczeniowy zawierający informacje o aktualnej trajektorii robota oraz adresy pinów do których zostaną podłączone piny XSHUT. 

Następnie w funkcji \texttt{setup()} wykonywana jest inicjalizacja czujników. Proces inicjalizacji rozpoczyna się od ustawienia odpowiedniego adresu dla każdego czujnika. Proces ten został opisany wcześniej. Kolejnym etapem jest właściwa inicjalizacja czujnika. Wykonywana jest ona za pomocą funkcji \texttt{init()} wywoływanej na każdej instancji obiektu czujnika. W przypadku błędnej inicjalizacji wyświetlany jest stosowny komunikat. Następnie dla każdego czujnika ustawiany jest czas maksymalnego oczekiwania na wartość (ang. timeout) za pomocą funkcji \texttt{setTimeout()}. Jest on ustawiony na wartość 500ms, zatem po tym czasie zostanie zwrócona wartość maksymalna dla typu UINT16. Ostatnim zadaniem jest przełączenia czujnika w tryb odczytu ciągłego za pomocą funkcji \texttt{setContinuous()}.

Następna funkcja typowa dla środowiska Arduino IDE to \texttt{setup()}. Funkcja ta zawiera wywołania czterech dodatkowych funkcji:
\begin{itemize}
    \item \texttt{searchForDevices()} - odpowiada za wyszukiwanie dostępnych urządzeń na magistrali I2C,
    \item \texttt{readFromSensor()} - odpowiada za odczytanie wartości z czujników,
    \item \texttt{processSensorInfo()} - odpowiada za interpretację otrzymanych wyników,
    \item \texttt{sendSteering()} - odpowiada za przesłanie instrukcji sterowania do urządzenia Slave.
\end{itemize}

\subsubsection*{Funkcja \texttt{searchForDevices()}}

Funkcja ta jest funkcją pomocniczą, niekonieczną do poprawnego działania programu. Jest ona jedna przydatna w celu weryfikacji poprawności połączenia urządzeń do magistrali I2C. W przypadku braku dostępnych urządzeń lub braku zgodności ich liczby należy zwrócić uwagę, czy wszystkie urządzenia są poprawnie podłączone do zasilania oraz do magistrali. Jeśli pierwsze w kolejności urządzenie podłączone do magistrali jest wadliwe lub zostało niepoprawnie podłączone, żadne kolejne urządzenie nie zostanie wykryte. 

Realizacja wyszukiwania dostępnych urządzeń (adresów) jest relatywnie prosta. W pętli \texttt{for} poprzez wywołanie funkcji \texttt{Wire.beginTransmission(int addr)} rozpoczynana jest próbna transmisja do potencjalnego urządzenia. Jeśli urzadzenie odpowie bez błędu, jego adres jest wyświetlany w konsoli w postaci liczby w formacie szesnastkowym.
\begin{figure}[H]
    \centering
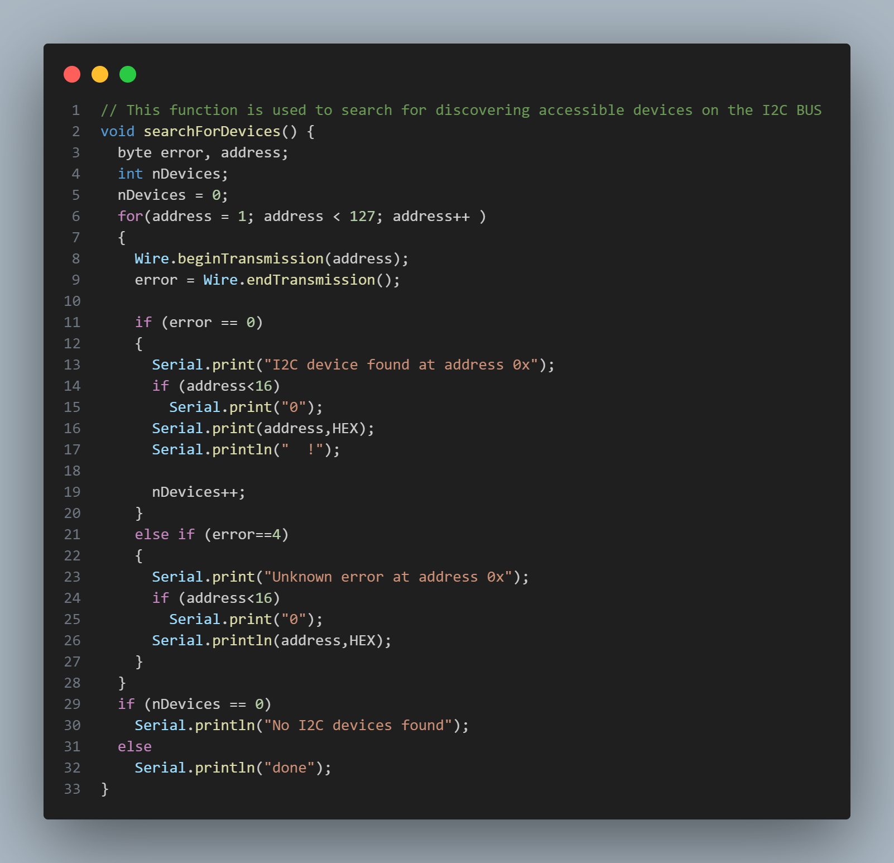
[picture p20: report/src/code_snaps/searchDevices.png]
    
    \caption{Kod źródłowy realizujący wyszukiwanie urządzeń dostępnych na magistrali I2C}
\end{figure}

\subsubsection*{Funkcja \texttt{readFromSensor()}}

Implementacja funkcji czytania wartości z sensora jest bardzo prosrtolinijna. Za pomocą matody \texttt{readRangeContinuousMillimeters()} wywołanej na odpowiednim obiekcie klasy VL53L0X odczytywana jest wartość odległości wyrażona w milimetrach. Jednocześnie odczytana wartość jest przypisywana do odpowiedniej komórki w tablicy pomiarów. 

We fragmencie kodu źródłowego można zauważyć wykomentowany fragment wyświetlający wartość odległości. Został on wykorzystany w celu walidacji danych odczytywanych z czujników.

\begin{figure}[H]
    \centering
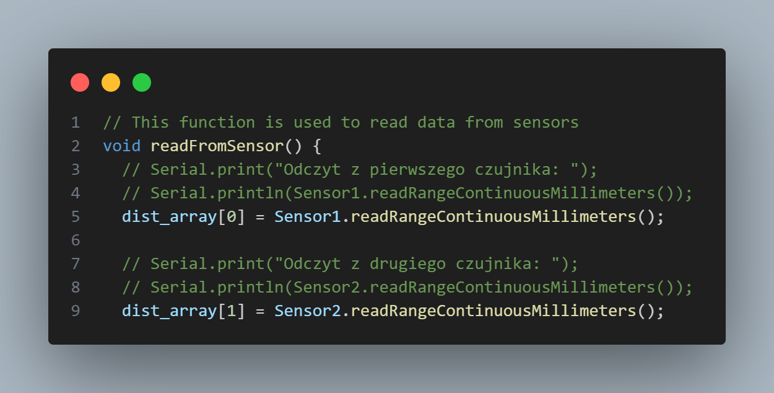
[picture p21: report/src/code_snaps/readFromSensor.png]
    
    \caption{Kod źródłowy realizujący odczytywanie odległości z czujnika}
\end{figure}

\subsubsection*{Funkcja \texttt{processSensorInfo()}}

Powyższa funkcja ma wagę fundamentalną pod kątem poprawności działania robota. Jednocześnie funkcja ta jest najbardziej złożona, przez co zostanie dodany cały kod źródłowy. 

Funkcja rozpoczyna się od inicjalizacji zmiennej \texttt{currentTime()}, jej sens wyjaśni się w miarę zgłębiania logiki wyznaczania sterowania. 

Pierwsza instrukcja warunkowa sprawdza czy robot znajduje się we wnęce. Stan domyślny jest ustawiony na \texttt{false}. Następnie, zgodnie z dodanymi komentarzami, jeśli przed robotem oraz z prawej strony strony odległość jest większa niż stała \texttt{SAFE\_DIST}, wtedy robot dojedzie do ściany. Funkcja zwraca wartość na podstawie typu wyliczeniowego nadmienionego wcześniej. Dodatkowo w celach pomocniczych wyświetlany jest komunikat o aktualnej trajektorii. 

Następne instrukcje warunkowe realizują sterowanie zgodnie z komentarzami. Warto zwrócić uwagę na instrukcję warunkową rozpoczynającą się w linii 15. Jeśli robot wykryje ścianę przed sobą, robot rozpoczyna ruch w lewo oraz przełącza flagę \texttt{wneka} na wartość \texttt{true}.

Jeśli została wykryta wnęka wykonuje się alternatywna sekwencja instrukcji warunkowych. Jeśli przed robotem ciągle znajduje się przeszkoda, jego ruch pozostaje niezmienny w lewo. W przypadku, gdy czujniki wykryją wolną przestrzeń, włączany jest tryb wyjeżdżania z wnęki. 

Opuszczanie wnęki zostało zrealizowane za pomocą licznika, stąd deklaracja zmiennej \texttt{currentTime} na początku funkcji. W linii nr 55 sprawdzany jest warunek, czy czas przeznaczony na wyjazd z wnęki minął. Jeśli tak, pojazd przełącza się w tryb normalny, jeśli nie, pojazd kontynuuje jazdę prosto. 

Wyjaśnienie wykorzystania takiej struktury zostanie opisane w sekcji 3.3. 

\begin{figure}[H]
    \centering
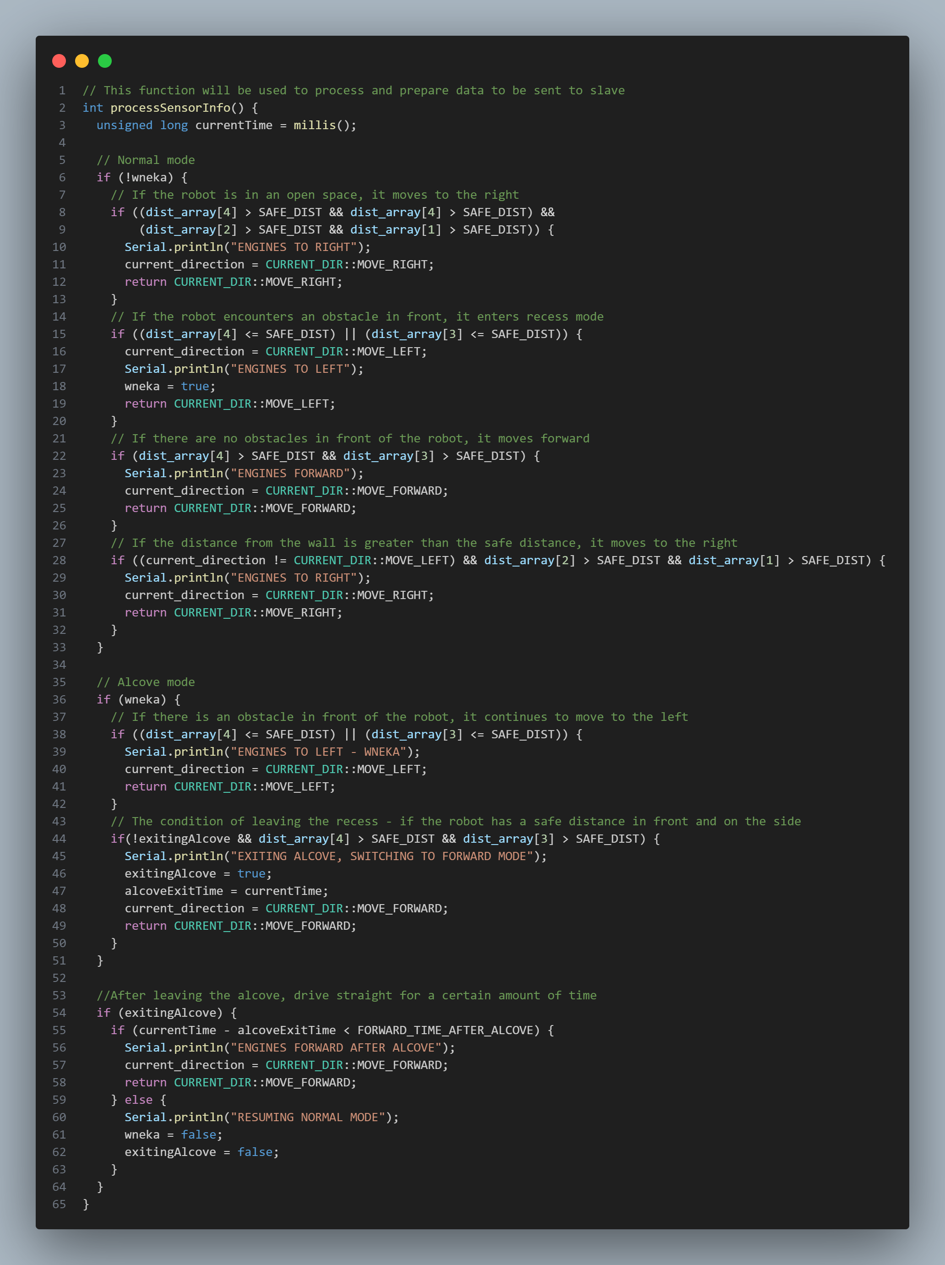
[picture p22: report/src/code_snaps/processInfo.png]
    
    \caption{Kod źródłowy realizujący wyznaczenie odpowiedniego sterowania}
\end{figure}

\newpage

\subsubsection*{Funkcja \texttt{sendSteering()}}

Funkcja ta realizuje wysyłanie wartości odczytanej z funkcji przetwarzającej dane z sensorów. Pierwszym krokiem jest rozpoczęcie transmisji z urządzeniem o adresie \texttt{0x09} - taki adres jest typowo przydzielany dla drugiego mikrokontrolera Arduino. Następnie za pomocą funkcji \texttt{Wire.write()} odbywa się właściwy przesył danych poprzez magistralę I2C.

\begin{figure}[H]
    \centering
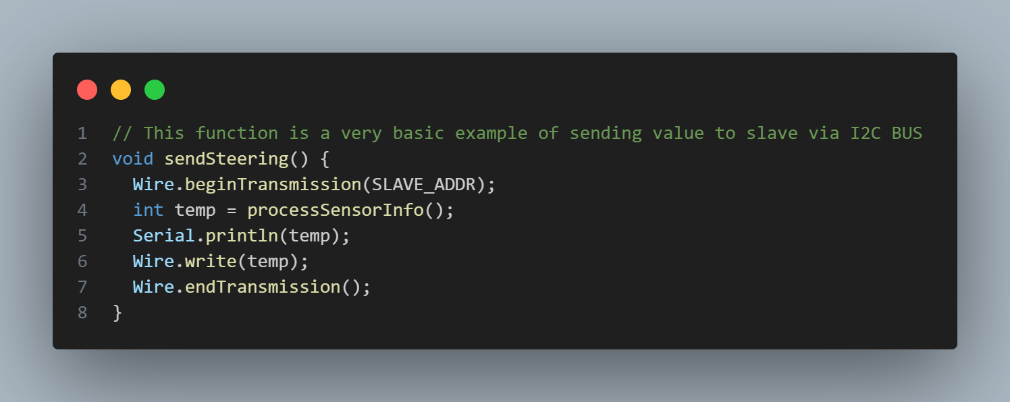
[picture p23: report/src/code_snaps/sendSteer.png]
    
    \caption{Kod źródłowy realizujący wysłanie instrukcji sterowania}
\end{figure}

\subsubsection{\Large Slave}

Mikrokontroler Arduino UNO R3 skonfigurowany do pracy typu Slave odbiera paczkę danych przez zmienną "rd" wysyłane przez Master.

\begin{figure}[H]
    \centering
    
    \caption{Fragment kodu źródłowego przedstawiający odbiór komunikatów przesyłanych przez mikrokontroler Master.}
    \label{fig:sensor_init}
\end{figure}

Zgodnie z odbieranym komunikatami o zmianie kierunku indeksowanymi od 0 do 3, program wywołuje odpowiednie funkcje. 

\begin{figure}[H]
    \centering
    
    \caption{Fragment kodu źródłowego przedstawiający implementację ruchu pojazdu w odpowiednich kierunkach.}
    \label{fig:sensor_init}
\end{figure}

Funkcje określające kierunek jazdy zostały skonstruowane wedle logiki i geometrii działania kół szwedzkich.

\begin{figure}[H]
    \centering
    
    \caption{Wizualizacja zależności kierunku jazdy od obrotu kół szwedzkich.}
    \label{fig:sensor_init}
\end{figure}

\subsection{\Large Testy poprawności działania algorytmu sterującego}

% --------------------------------------------------------
% Autor: Wszyscy
%
% TODO: Opisać proces testowania oraz rezultaty algorytmu testującego
%
% Status: Jakub - 80% (? idk czy ktoś chce coś dodać)
% --------------------------------------------------------

Testy algorytmu sterującego w początkowej fazie były przeprowadzane poprzez analizę danych wyświetlanych w konsoli środowiska Arduino IDE. Wartości zwracane przez funkcje były weryfikowane w zależności od tego, które czujniki były zakryte.

Kolejnym etapem było wdrożenie algorytmu na rzeczywisty obiekt oraz ocena jego działania w środowisku rzeczywistym. Na podstawie dalszej analizy działania algorytmu, czas opóźnienia przełączenia w tryb normalny był dostosowywany w zależności od prędkości obrotowej silników.

Należy podkreślić, że algorytm sterujący w pełni spełnia założone wymagania. Jednakże, z powodu niedoskonałości konstrukcyjnych oraz ograniczeń elementów elektronicznych, robot nie realizuje założonych scenariuszy w sposób idealny.

\begin{figure}[H]
\centering
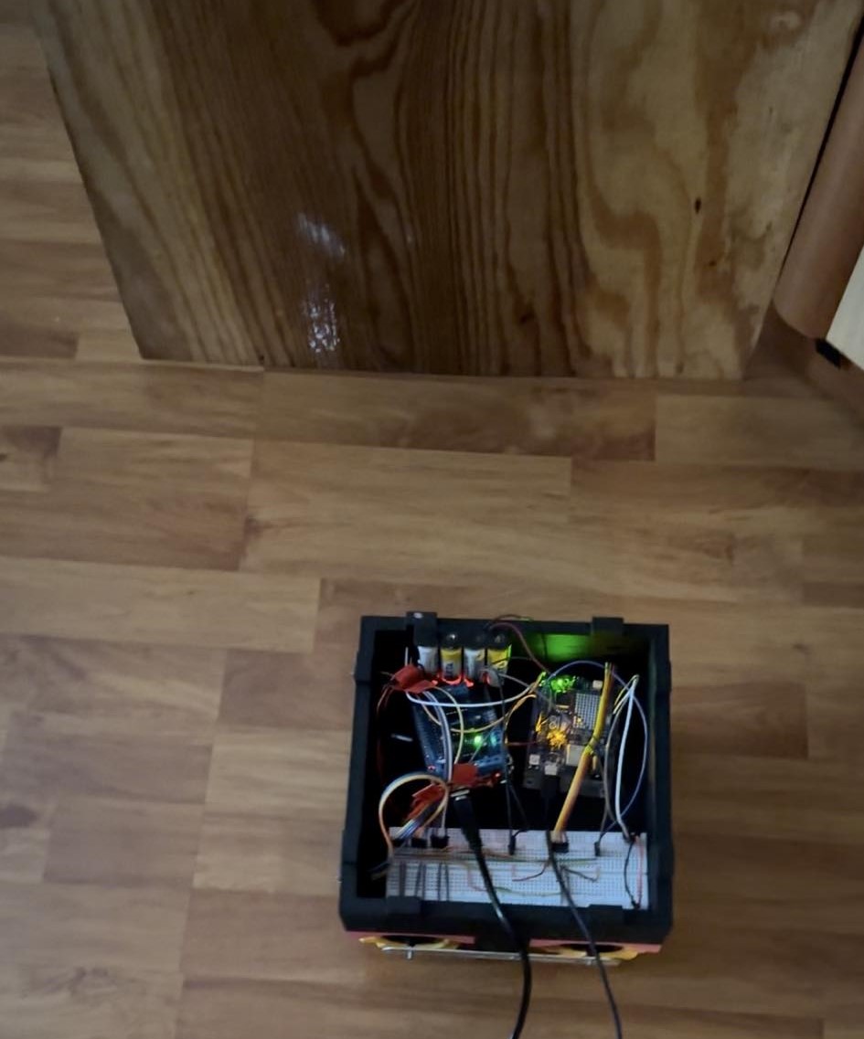
[picture p24: report/src/Robot_pics/test1.jpg]

\caption{Symulacja ściany, do której robot dojeżdża}
\end{figure}

\begin{figure}[H]
\centering
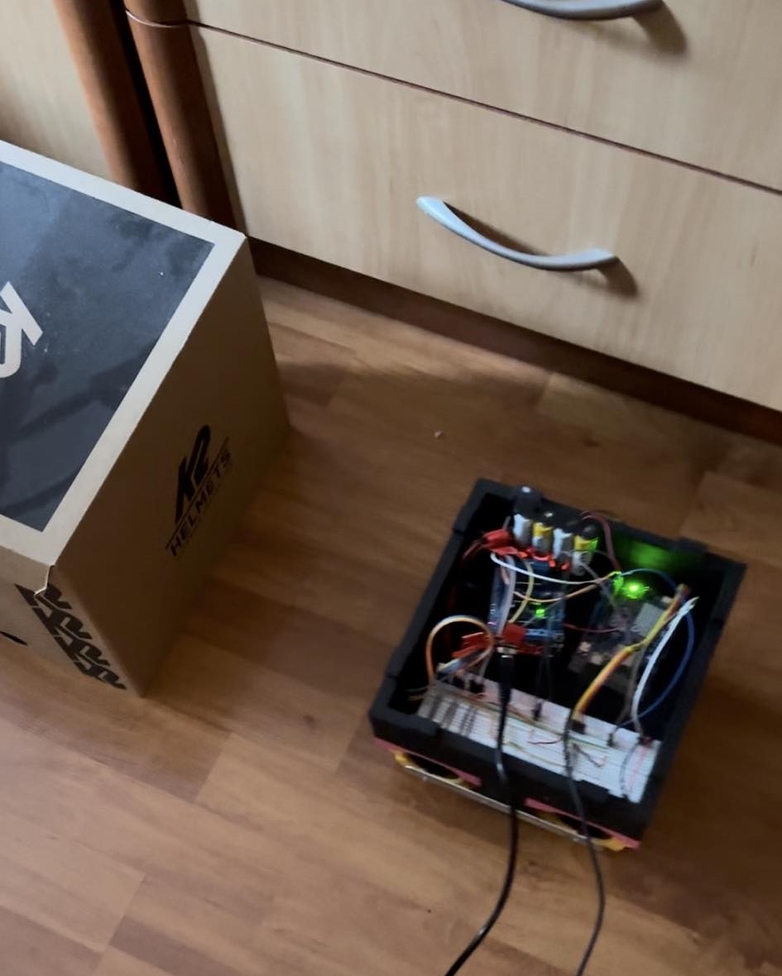
[picture p25: report/src/Robot_pics/test2.jpg]

\caption{Koniec symulowanej wnęki - robot rozpoczyna wyjazd z wnęki}
\end{figure}

\section{\LARGE Napotkane problemy}
\subsection{\Large Podłączenie laserowych czujników odległości}
% --------------------------------------------------------
% Autor: Jakub Pająk
%
% TODO: Opisać problemy podczas podłączenia czujników laserowych
%
% Status: 100%
% --------------------------------------------------------

Problematyczne okazało się użytkowanie więcej niż jednego czujnika laserowego przy wykorzystaniu magistrali I2C. Było to spowodowane domyślnym adresem, który był taki sam dla wszystkich czujników. 

Naturalnym krokiem jest wykorzystanie funkcji \texttt{setAddress()}, ustawiającej inny niż domyślny adres dla czujnika. Niestety wykorzystanie tylko tej funkcji nie przyniosło oczekiwanych rezultatów, w wyniku czego należało szukać rozwiązania dalej. 

Na podstawie dokumentacji oraz informacji znalezionych na forach internetowych, okazało się, że aby z sukcesem zmienić adres czujnika należy wykorzystać dodatkowy pin o nazwie XSHUT. Dzięki niemu czujnik zapamiętywał zmianę adresu i możliwe było wykorzystanie zamierzonej liczby sensorów. 

Dokładny sposób podłączenia czujników oraz wykorzystania pinu XSHUT został opisany w sekcji nr 2.8.

\subsection{\Large Montaż silników oraz kół}
% --------------------------------------------------------
% Autor: Wszyscy
%
% TODO: Opisać problemy podczas montażu
%
% Status: 80%
% --------------------------------------------------------
Pierwszym problemem było zamontowanie samych silników, okazało się że otwory na mocowanie silników znajdowały się w innych miejscach niż było to potrzebne. W związku z tym, konieczne było wprowadzenie listwy aluminiowej, która pozwoliła na stabilne przymocowanie silników do dolnej części pojazdu.

Kolejnym wyzwaniem było mocowanie kół do silników. Początkowo użyto długich śrub, jednak okazało się, że koła są zbyt niestabilne. Aby wyeliminować luzy, wprowadzono boczne listwy aluminiowe, przez które przechodza długie gwintowane szprychy. To rozwiązanie znaczenie poprawiło stabilność kół i zminimalizowało luzy, zapewniając lepsze działanie całego układu.

Dzięki tym działaniom udało się rozwiązać napotkane problemy i zakończyć montaż kół i silników w sposób zapewniający solidność i niezawodność konstrukcji.   

\subsection{\Large Implementacja logiki sterowania}
Realizacja logiki realizującej śledzenie ściany bez elementu opuszczania wnęki była relatywnie prosta. Jednak dodanie sekwencji wyjeżdżania z wnęki okazało się wyzwaniem.

Było tak ze względu na kolejność instrukcji warunkowych. Pierwotnie jeśli robot dojeżdżał do ściany jednocześnie mając z prawej swojej strony przeszkodę, poprawnie rozpoczynał ruch w lewo. Jednak po otrzymaniu informacji z sensora o pustej przestrzeni przed, robot od razu rozpoczynał ruch w prawo, ze względu na oddalenie się od prawej strony ściany. W wyniku czego pojazd jeździł tam i z powrotem w kółko. 

Rozwiązaniem okazało się zastosowanie dodatkowego warunku sprawdzającego stan flagi \texttt{wneka} oraz wykorzystanie wymuszonego ruchu do przodu - opisany wcześniej licznik. Dzięki wykorzystaniu wymienionych ulepszeń, robot zarejetrowaniu pustej przestrzeni przed sobą, przez określony czas poruszał się przed siebie, w wyniku czego przynajmniej jeden z czujników z jego prawej strony otrzymywał owartość uniemożliwiającą ruch w prawo. 

\section{\LARGE Podsumowanie}
% --------------------------------------------------------
% Autor: Wszyscy
%
% TODO: Napisać zgrabne podsumowanie projektu, czego się nauczyliśmy oraz sensowne wnioski do popełnionych błędów.
%
% Status: Jakub - 100% (?) idk czy ktoś chce coś dodać
% --------------------------------------------------------

Cel projektu został zrealizowany z sukcesem. Robot został skonstruowany zgodnie z założeniami wstępnymi i realizuje cele określone na początku projektu. Niemniej jednak, działanie robota nie jest idealne z powodu problemów uniemożliwiających jazdę w liniach prostych.

Problem ten mógłby zostać zminimalizowany poprzez zastosowanie enkoderów w silnikach. Enkodery umożliwiłyby precyzyjne określenie prędkości obrotowej i jej śledzenie w czasie rzeczywistym, co pozwoliłoby na bardziej precyzyjną regulację. Rozwiązanie to nie zostało wdrożone z powodu ograniczonego czasu oraz wątpliwości dotyczących możliwości podłączenia dodatkowych czujników do obecnego układu mikrokontrolerów.

Dodatkowo, poprawa jakości silników i zastosowanie bardziej zaawansowanych sterowników, na przykład dwóch wysokiej klasy sterowników dwukanałowych, mogłaby znacząco zmniejszyć różnice w prędkościach obrotowych silników.

Projekt ten pozwolił zespołowi na dogłębne zapoznanie się z procesem tworzenia prostego robota mobilnego. Zdobyte doświadczenia w zakresie doboru ogniw zasilających, implementacji algorytmu sterowania oraz integracji czujników będą cennym zasobem w przyszłych projektach.

W trakcie realizacji projektu napotkano wiele nieprzewidzianych problemów, co z kolei przyczyniło się do rozwoju umiejętności rozwiązywania problemów, niezwykle cenionych na 
aktualnym rynku pracy. 

\newpage

\nocite{*}
\printbibliography

\end{document}
