JakubPajak/arduino_robot/report/report.pdf

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

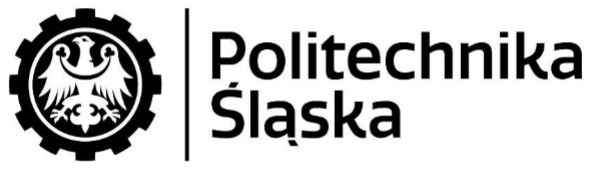
[picture p26: figure]

# Spis tre±ci

## 2.4. Implementacja prostego skryptu w odczytuj¡cego dane z ka-

## 2.6. Implementacja prostego kodu werykuj¡cego prawidªowe pod-

## 2.7. Podª¡czenie oraz werykacja poprawno±ci dziaªania czujni-

## 2.9. Monta» ogniw wraz z ukªadem BMS oraz podª¡czenie czuj-

## 2.10. Integracja czujników z silnikami oraz implementacja logiki

## 1. Wprowadzenie

## 1.1. Cel projektu

Celem niniejszego projektu jest opracowanie mobilnej platformy robotycznej, zdolnej do automatycznego utrzymywania okre±lonej odlegªo±ci od ±ciany. Platforma ta bazowa¢ b¦dzie na mikrokontrolerze Arduino oraz laserowych czujnikach odlegªo±ci typu ToF (ang. Time of Flight). Projekt ma na celu zbadanie i rozwini¦cie zaawansowanych algorytmów sterowania i nawigacji, które umo»liwi¡ precyzyjne ±ledzenie ±cian w zmiennych warunkach ±rodowiskowych. Dodatkowym celem jest stworzenie wszechstronnego rozwi¡-zania, które mo»na ªatwo dostosowa¢ do ró»nych zastosowa«, takich jak roboty sprz¡taj¡ce, inspekcyjne czy systemy autonomiczne w logistyce.

## 1.2. Zaªo»enia wst¦pne

Robot zostanie zaprojektowany w oparciu o mikrokontroler Arduino Uno R4, wybrany ze wzgl¦du na wbudowany moduª Bluetooth LE (LE - Low Energy), co umo»liwi zdalne monitorowanie i kontrol¦. Silniki zastosowane w projekcie musz¡ by¢ wyposa»one w enkodery, b¡d¹ umo»liwia¢ ich doª¡czenie, co zapewni precyzyjne sterowanie. Czujniki odlegªo±ci zostan¡ podª¡czone do mikrokontrolera za pomoc¡ magistrali I2C. Ze wzgl¦du na planowan¡ liczb¦ czujników (osiem), poª¡czenie ich innymi metodami nie byªoby efektywne.
Zasilanie platformy musi by¢ wystarczaj¡ce do obsªugi co najmniej jednego mikrokontrolera oraz czterech silników. Optymalnym rozwi¡zaniem b¦dzie zastosowanie czterech ogniw litowo-jonowych poª¡-czonych w konguracji 2S2P, co zapewni odpowiedni¡ wydajno±¢ energetyczn¡. Dodatkowo, konieczne jest zastosowanie ukªadu zarz¡dzania bateri¡ BMS (ang. Battery Management System), który zabezpieczy ogniwa przed nadmiernym rozªadowaniem i przeªadowaniem.
Caªo±¢ konstrukcji zostanie zamkni¦ta w obudowie wykonanej technik¡ druku 3D. Obudowa b¦dzie podzielona na dwie gªówne sekcje: doln¡, w której zostan¡ umieszczone silniki oraz ogniwa wraz z ukªadem BMS, oraz górn¡, zawieraj¡c¡ pªytk¦ stykow¡, mikrokontroler oraz czujniki. Taka konstrukcja zapewni ªatwy dost¦p do kluczowych komponentów i umo»liwi ich sprawn¡ wymian¦ w razie potrzeby. Pocz¡tkowo plan realizacji projektu zakªadaª stworzenie aplikacji, która byªaby odpowiedzialna za zdalne sterowanie robotem poprzez moduª BLE (ang. Bluetooth Low Energy). W wyniku pó¹niejszych konsultacji plan ulegª zmianie jednak aplikacja zostanie wykorzystana jako wsparcie dla automatycznego trybu robota.

## 2. Realizacja projektu

Projekt byª realizowany etapami, jednak nie zostaª zastosowany szczegóªowy harmonogram. Przybli»one etapy rozwoju projektu:

1. Napisanie aplikacji w wersji dedykowanej systemowi Android w j¦zyku Dart,
2. Realizacja prostego skryptu w Arduino IDE w celu werykacji poª¡czenia BLE z mikrokontrolerem,
3. Wykonanie projektu obudowy robota w 3D oraz przygotowanie do druku,
4. Wykonanie prostego kodu w celu werykacji poprawno±ci podª¡czenia silników do sterownika,
5. Podª¡czenie oraz werykacja poprawno±ci dziaªania laserowych czujników odlegªo±ci,
6. Monta» silników wewn¡trz dolnej komory obudowy,
7. Monta» ogniw wraz z ukªadem BMS,
8. Integracja czujników z silnikami oraz implementacja logiki sterowania,
9. Testy poprawno±ci dziaªania algorytmu steruj¡cego.

## 2.1. Panel sterowania w aplikacji

Podczas analizy mo»liwych rozwi¡za« problemu zdalnego sterowania robotem wybór padª na wykonanie aplikacji mobilnej oraz przesyªanie odpowiednich komend za pomoc¡ protokoªu BLE. Protokóª BLE jest pewnym szczególnym przypadkiem ogólnego protokoªu Bluetooth, jest on szczególnie cz¦sto spotykany w przypadku mniej zaawansowanych mikrokontrolerów takich jak Arduino Uno R4. Dzi¦ki odpowiedniej architekturze, protokól ten pozwala na bardziej efektywne zarz¡dzanie pobieran¡ energi¡ jednocze±nie zachowuj¡c niezb¦dne funkcjonalno±ci.
Przez wzgl¡d na wcze±niej nabyte umij¦tno±ci tworzenia aplikacji za pomoc¡ j¦zyka Dart przez jednego z czªonków sekcji, prace nad projektem rozpocz¦to od implementacji podstawowej wersji aplikacji realizuj¡cej proste przesyªanie informacji w postaci caªkowitoliczbowej w celu pó¹niejszej interpretacji otrzymanych danych w ±rodowisku Arduino.
Przez wzgl¡d na tematyk¦ projektu implementacja aplikacji nie zostanie w poni»szym raporcie szczegóªowo omówiona. Zostanie przedstawiony podstawowy interfejs graczny oraz zasada dziaªania kluczowych funkcji, takich jak poª¡czenie lub realizacja przesyªu danych. Autor uwa»a, i» pewne wyszczególnienie cz¦±ci metod oraz zastosowanych bibliotek mo»e pomóc niektórym osobom w prostrzym znalezieniu informacji na temat poprawnie dziaªaj¡cego poª¡czenia z mikrokontrolerem Arduino poprzez Bluetooth.
2.1.1. Interfejs u»ytkownika aplikacji

## 2.2. Implementacja poª¡czenia Bluetooth

## 2.3. Implementacja przesyªania danych

## 2.4. Implementacja prostego skryptu w odczytuj¡cego dane z kanaªu BLE

Fragment prezentowanego kodu rozpoczyna si¦ od zadeklarowania zmiennych globalnych opisuj¡cych charakterystyki poª¡czenia Bluetooth. Pierwsza charakterystyka okre±la identykator typu GUID serwisu, nast¦pna okre±la na jaki identykator przesyªane s¡ zdarzenia typu "request". Ostatnia warto±¢ deniuje indentykator na jaki s¡ przesyªane zdarzenia typu 'response". W przypadku aktualnej wersji aplikacji istotna jest tylko warto±¢ identykuj¡ca serwis oraz zdarzenia typu request, poniewa» mikrokontroler nie zwraca »adnej informacji do aplikacji. W razie dalszego rozwoju projektu zostanie zaimplementowanie wy±wietlanie diagnostyki robota, stanu naªadowania baterii oraz stanu pracy silników.
Funkcja t5Callback() ma za zadanie pobiera¢ warto±¢ która aktualnie zostaªa przesªana do kanaªu Bluetooth z poziomu aplikacji. Argumenty wej±ciowe funkcji to urz¡dzenie z którym Arduino nawi¡zaªo poª¡czenie, drugi argument to wcze±niej wspomniany identykator zdarzenia "request".
Nast¦pnie warto±¢ jest odczytywana z kanaªu za pomoc¡ funkcji readValue(). Funkcja ta jest cz¦±ci¡ biblioteki ArduinoBLE.h.
W funkcji setup() nast¦puje inicjalizacja odpowiednich charakterystyk oraz za pomoc¡ funkcji setEventHandler() zostaje okre±lona sytuacja w której nast¡pi wywoªanie funkcji t5Callback oraz odczytanie danych z kanaªu.

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

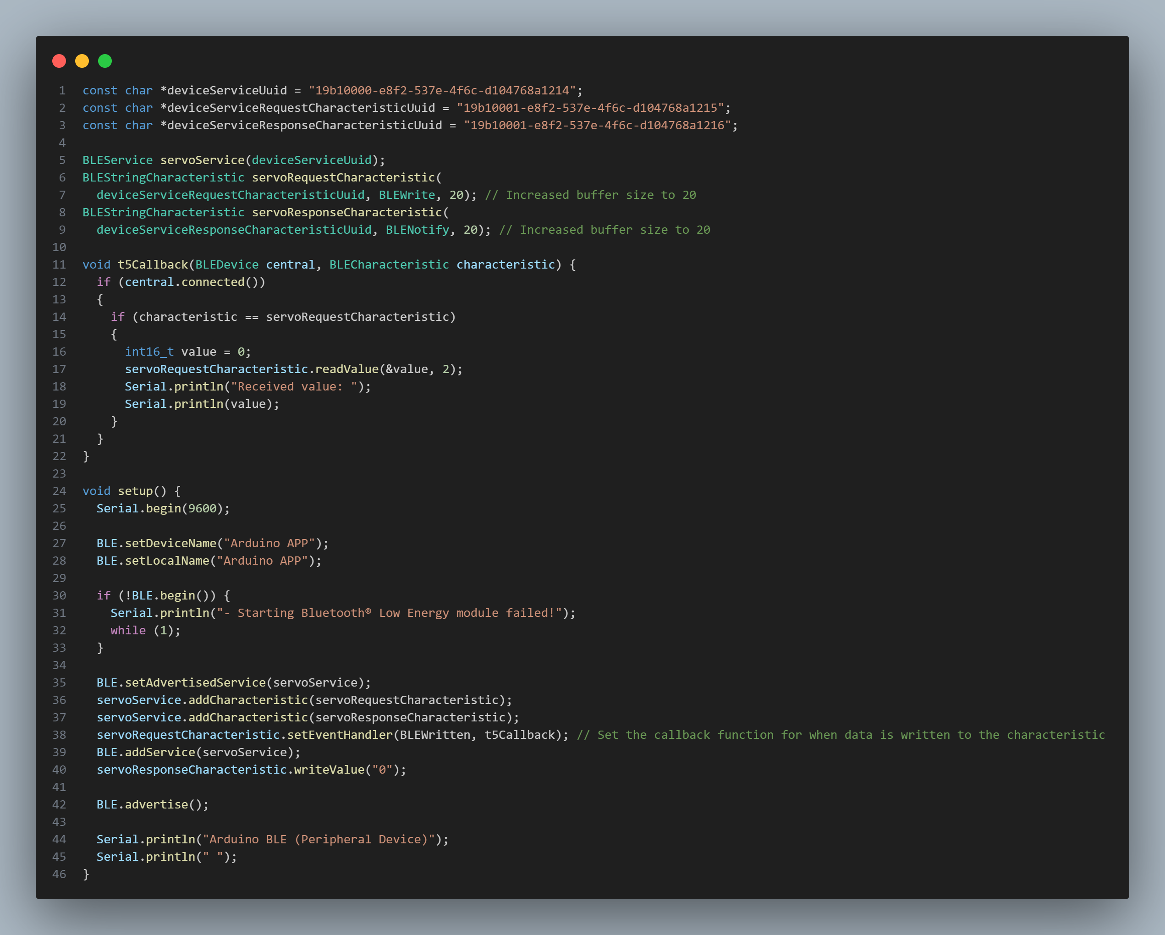
[picture p27: figure]

## 2.5. Proces wykonywania projektu obudowy robota

Proces projektowania obudowy dla platformy je»d»¡cej stanowiª wieloetapowe zadanie, które wymagaªo dokªadnego zaplanowania i licznych poprawek. Pierwsza faza obejmowaªa stworzenie prototypu, który miaª na celu optymalne rozmieszczenie komponentów oraz werykacj¦ ich poprawnego dziaªania. Ten etap pozwalaª zidentykowa¢ ewentualne problemy konstrukcyjne i funkcjonalne na wczesnym etapie prac.

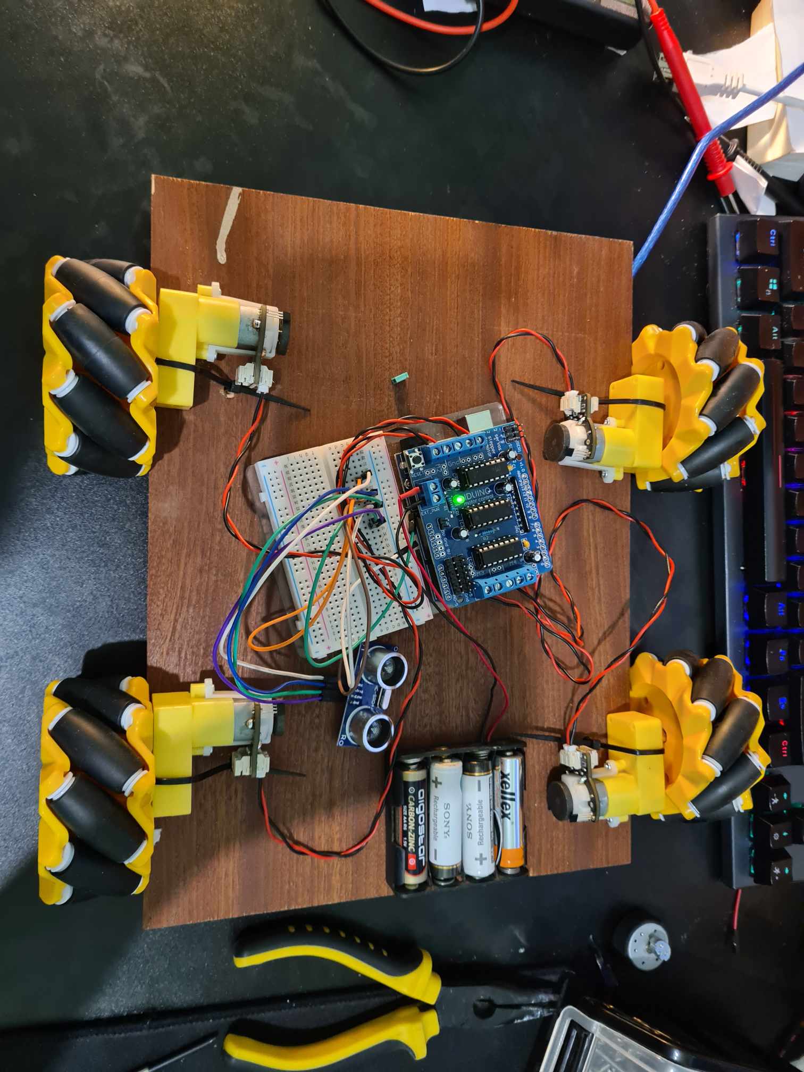
[picture p28: figure]

Rysunek 2: Prototypowa konstrukcja maj¡ca na celu sprawdzenie poprawno±ci dziaªania komponentów.

Kolejnym krokiem byªo opracowanie specjalnej obudowy, zdolnej pomie±ci¢ wszystkie wymagane elementy, przy jednoczesnym zachowaniu odpowiedniej geometrii kóª szwedzkich (zwanych równie» koªami Mecanum). Aby robot dziaªaª zgodnie z zaªo»eniami, koªa musiaªy by¢ rozmieszczone w orientacji X Y równych odst¦pach od siebie, a ich rolki powinny by¢ skierowane do ±rodka. Konieczne jest aby z rzutu górnego posiadaª przedªu»enie osi kóª w ksztaªcie znaku X.

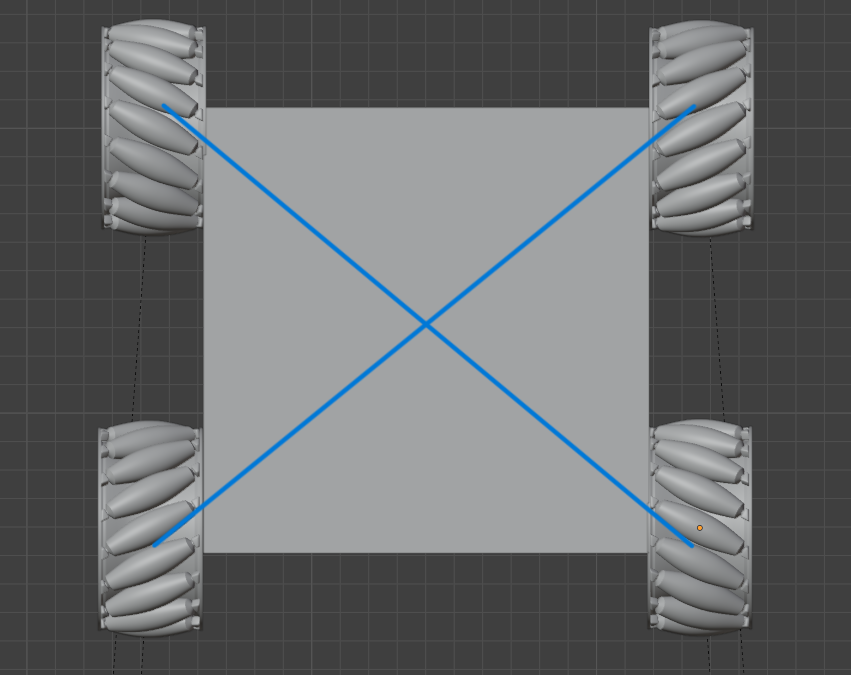
[picture p29: figure]

Rysunek 3: Plan rozmieszczenia kóª szwedzkich. Kluczowe jest zachowanie kóª w równych odst¦pach od siebie oraz utworzenie znaku X.

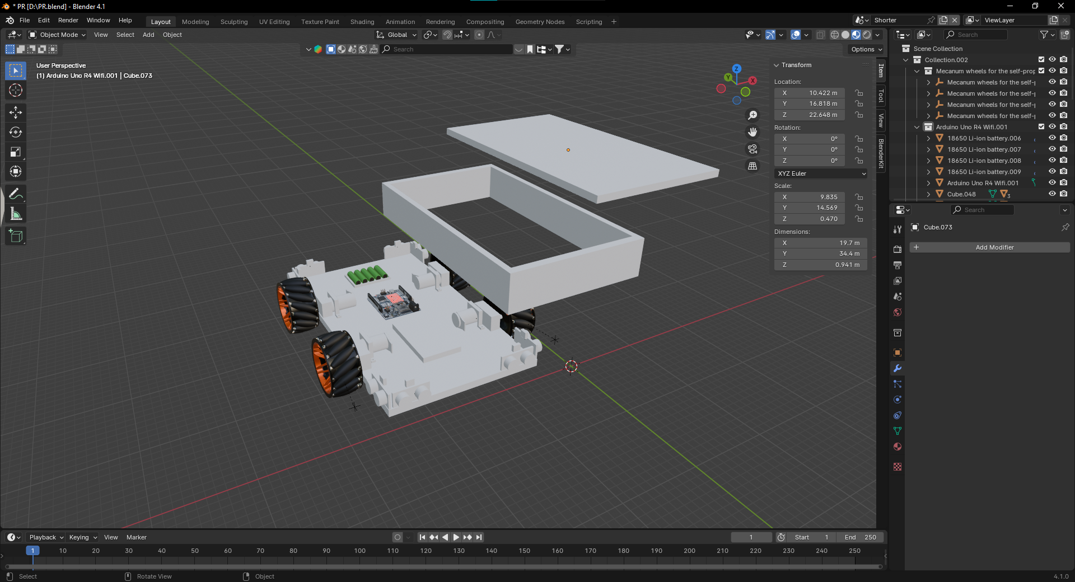
[picture p30: figure]

Rysunek 4: Pierwsza wersja projektu zamodelowana w programie Blender 4.1.

Jednak»e podczas pierwszego etapu projektu nast¡piªy problemy logiczne i konstrukcyjne. Pierwotnie u»ywany darmowy program Blender 4.1 okazaª si¦ niewystarczaj¡cy ze wzgl¦du na niezgodno±¢ formatów eksportu z wymaganiami dost¦pnej drukarki 3D. W zwi¡zku z tym, konieczne byªo przej±cie na bardziej zaawansowane narz¦dzie, jakim jest AutoDesk Fusion. To oprogramowanie pozwoliªo na dokªadniejsze zaprojektowanie modelu, uwzgl¦dniaj¡c specykacj¦ drukarki, która posiadaªa obszar roboczy o wymiarach 25 cm x 25 cm. Z tego powodu, model musiaª zosta¢ zaprojektowany od nowa, z uwzgl¦dnieniem ogranicze«.

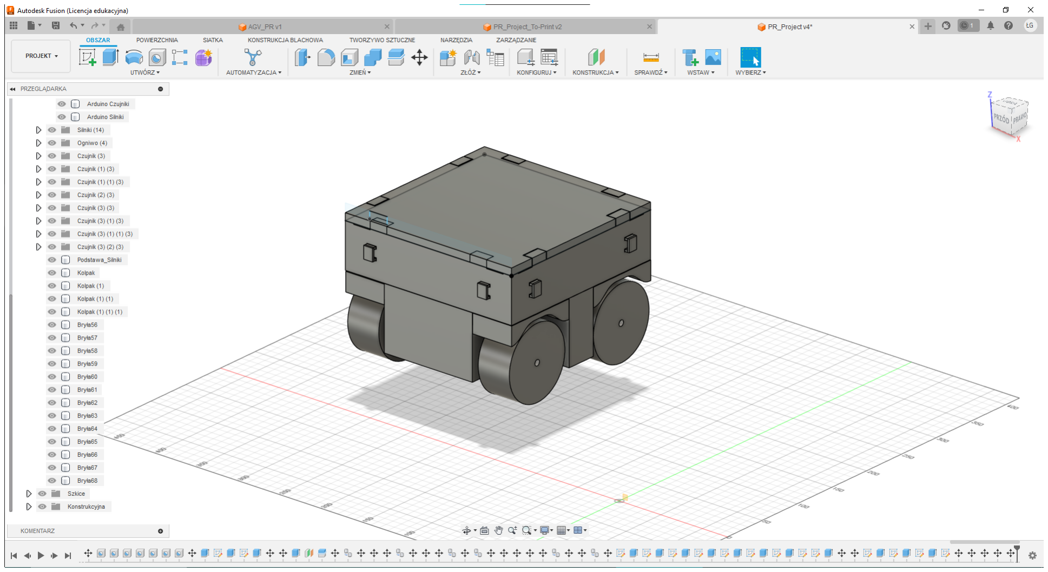
[picture p31: figure]

Rysunek 5: Wizualizacja gotowego modelu w programie AutoDesk Fusion.

Gotowy produkt skªada si¦ z dwóch pi¦ter, z których ka»de peªni inn¡ funkcje. Pierwsze pi¦tro to "pi¦tro maszynowe", gdzie umieszczone zostaªy moduªy nap¦dowe, takie jak silniki k¡towe z przekªadnia oraz ogniwa zasilaj¡ce w ilo±ci dwóch wraz ze sterownikiem BMS. Wszystkie istotne kable zostaªy przeprowadzone przez specjalnie przygotowany otwór do drugiego pi¦tra.


Rysunek 6: Widok rzutu górnego na pierwsze pi¦tro modelu. Znajduj¡ si¦ w nim silniki k¡-towe z przekªadni¡ oraz miejsce na ogniwa zasilaj¡ce wraz z BMS.

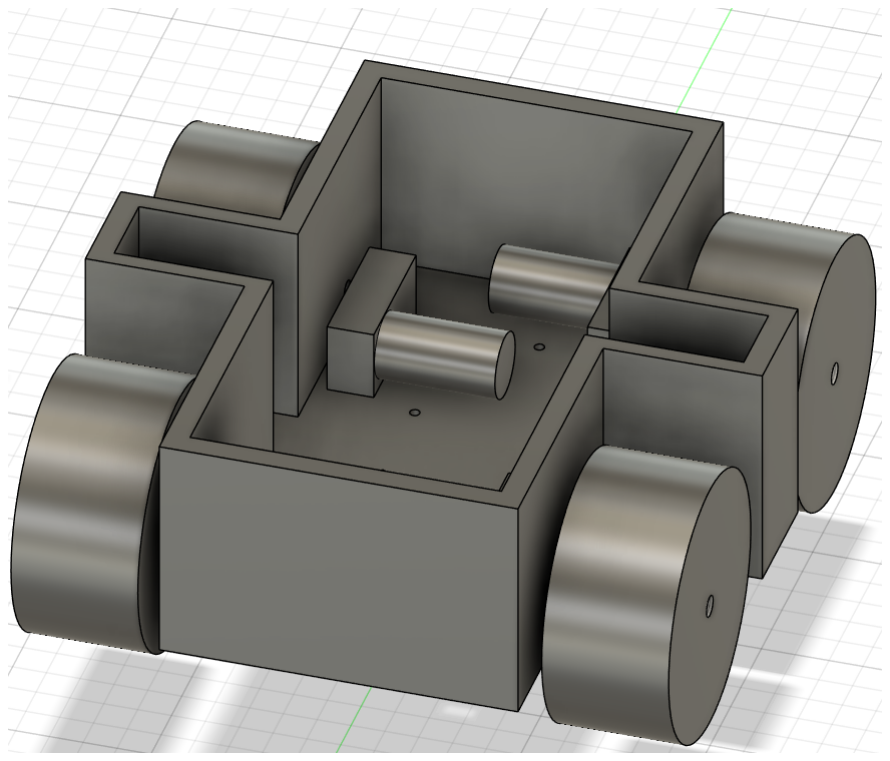
[picture p32: figure]

Rysunek 7: Widok rzutu bocznego na pierwsze pi¦tro modelu.

Drugie pi¦tro to "mózg operacyjny"caªego projektu. Zawiera ono kluczowe poª¡czenia elektroniczne, w tym dwa mikrokontrolery Arduino UNO 4 i 3 w konguracji Master-Slave, oraz osiem czujników laserowych umieszczonych w przygotowanych otworach na ±cianach bocznych. Takie rozmieszczenie i organizacja komponentów pozwalaj¡ na efektywne zarz¡dzanie funkcjami robota.

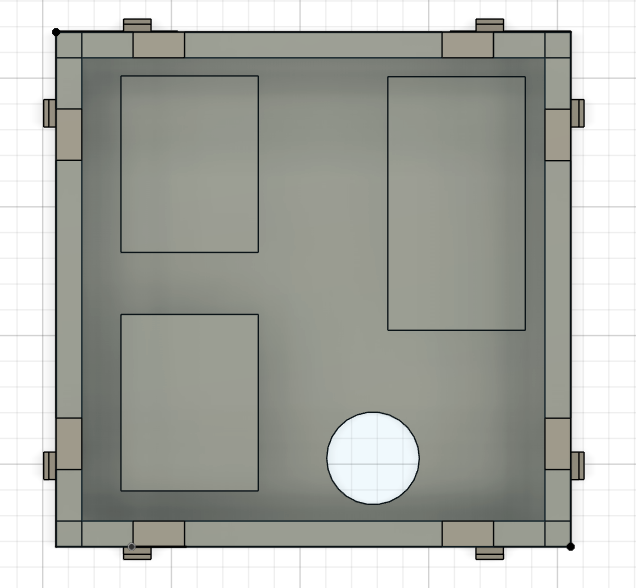
[picture p33: figure]

Rysunek 8: Widok rzutu górnego na drugie pi¦-tro modelu. Znajduj¡ si¦ w nim dwa mikronotrolery Arduino UNO oraz pªytka stykowa.

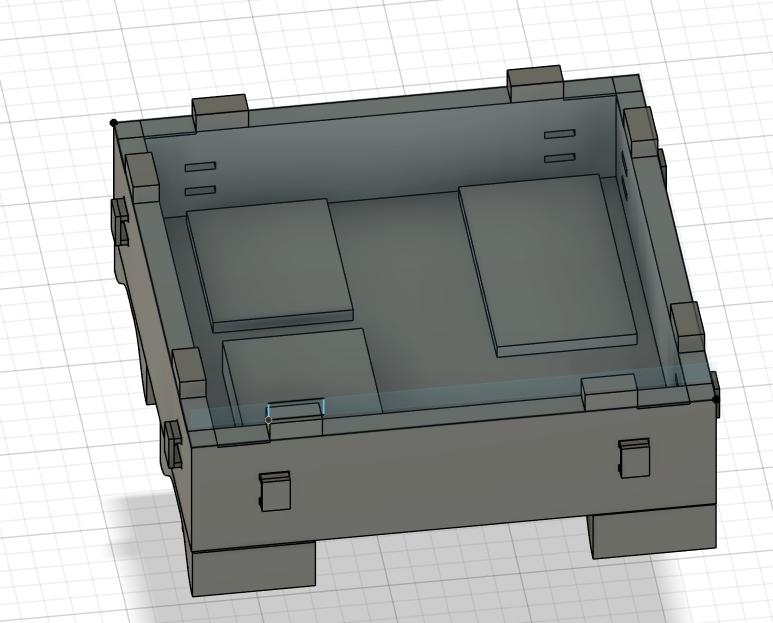
[picture p34: figure]

Rysunek 9: Widok rzutu bocznego na drugie pi¦tro modelu.

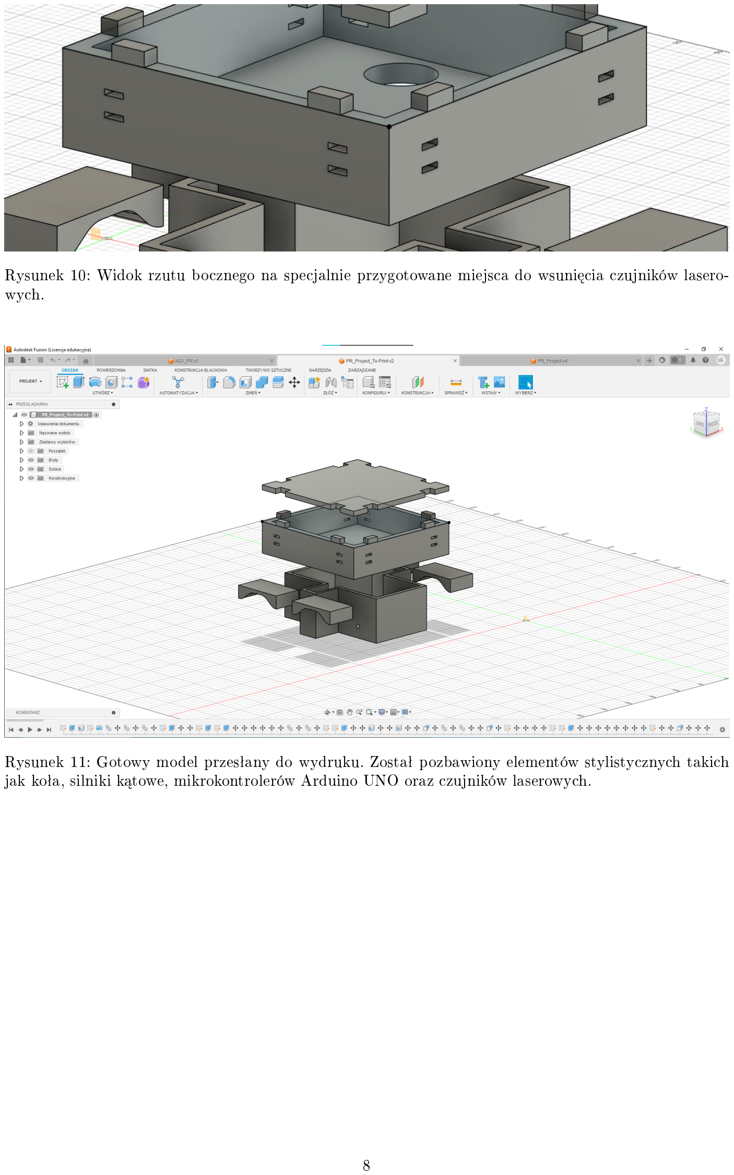
[picture p35: page 9]

Rysunek 10: Widok rzutu bocznego na specjalnie przygotowane miejsca do wsuni¦cia czujników laserowych.

Rysunek 11: Gotowy model przesªany do wydruku. Zostaª pozbawiony elementów stylistycznych takich jak koªa, silniki k¡towe, mikrokontrolerów Arduino UNO oraz czujników laserowych.

Gotowy model zawiera si¦ w wymiarach 20 cm x 20 cm x 15 cm oraz wykonuje wszystkie zadane ruchy zdolne do wykonania tylko przy pomocy kóª szwedzkich. Pojazd wykonuje jazd¦ w kierunku w przód i w tyª oraz w lewo i w prawo jak i obrót w miejscu.

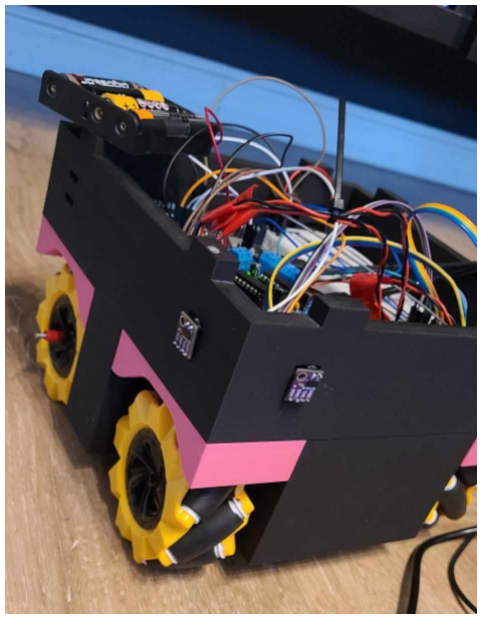
[picture p36: figure]

Rysunek 12: Gotowy model po zªo»eniu wszystkich elementów w caªo±¢.

## 2.6. Implementacja prostego kodu werykuj¡cego prawidªowe podª¡czenie silników

Do poª¡czenia silników z Arduino wykorzystano nakªadk¦ Iduino ST1138. Umo»liwia ona sterowanie czterema silnikami pr¡du staªego, o poborze pr¡du do 600 mA i napi¦ciu zasilania do 36 V. Nakªadka jest zasilana dwoma ogniwami 18650.
Werykacja poª¡czenia silników zostaªa wykonana przy u»yciu skryptu zamieszczonego poni»ej. Na pocz¡tku skryptu dodane s¡ biblioteki Wire i AFMotor. Biblioteka Wire jest wykorzystywana do poª¡czenia obu moduªów Arduino w konguracji master-slave, natomiast biblioteka AFMotor sªu»y do sterowania silnikami z nakªadki Iduino.
W nast¦pnych liniach zdeniowane s¡: adres urz¡dzenia slave oraz globalna warto±¢ bezpiecznego dystansu, który jest potrzebny, aby w przypadku wystaj¡cego gzymsu, który mógªby omin¡¢ czujniki, pojazd nie zahaczyª o niego.
Dalsza cz¦±¢ kodu zawiera wykorzystanie biblioteki AFMotor i przypisanie konkretnych silników do zmiennych.
W ostatniej cz¦±ci, czyli setup, znajduje si¦ poª¡czenie przez bibliotek¦ Wire, rozpocz¦cie komunikacji z pr¦dko±ci¡ 9600 bitów na sekund¦ (Serial.begin(9600)) oraz ustawienie pr¦dko±ci wszystkich silników. Do werykacji dziaªania silników mo»na zakomentowa¢ pozostaªe ustawienia setSpeed, tak aby pozostaªo tylko jedno i sprawdzi¢, który silnik jest uruchomiony.

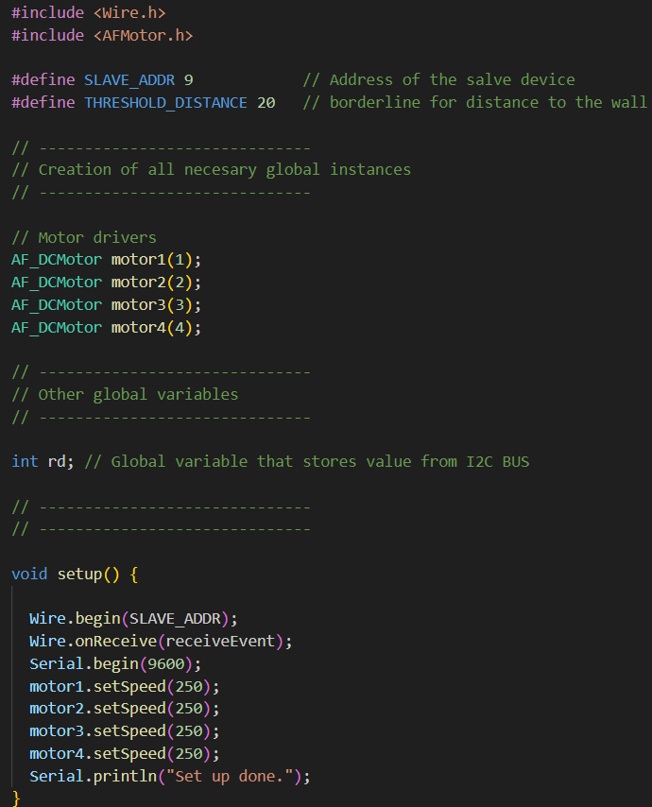
[picture p37: figure]

Rysunek 13: Framgent kodu ¹ródªowego przedstawiaj¡cy werykacje prawidªowego poª¡czenia silników

## 2.7. Podª¡czenie oraz werykacja poprawno±ci dziaªania czujników laserowych

We wczesnej fazie planowania zakªadano wykorzystanie ultrad¹wi¦kowych czujników odlegªo±ci. Pomysª ten okazaª si¦ nietraony ze wzgl¦du na sposób przekazywania danych przez te czujniki. Ka»dy czujnik posiada dwa wyprowadzenia, co przy u»yciu o±miu czujników wymagaªoby wykorzystania co najmniej 16 pinów Arduino.
Nast¦pnie analiza skupiªa si¦ na wykorzystaniu magistrali I2C, która umo»liwia podª¡czenie du»ej liczby czujników za pomoc¡ niewielkiej liczby pinów. Kluczowym warunkiem jest poprawna komunikacja mi¦dzy czujnikiem a mikrokontrolerem.
Laserowe czujniki odlegªo±ci VL530L0X okazaªy si¦ trafnym wyborem ze wzgl¦du na ich korzystny stosunek jako±ci do ceny. Pomiary odlegªo±ci s¡ wystarczaj¡co dokªadne, a bior¡c pod uwag¦ charakter obiektu wykrywanego, wysoka precyzja nie jest wymagana.
Czujniki zostaªy podª¡czone zgodnie z przeznaczeniem poprzez magistral¦ I2C. Kluczow¡ rol¦ w podª¡czaniu wielu identycznych czujników odegraªo u»ycie dodatkowego pinu XSHUT oraz odpowiedniej sekwencji kodu, aby pomy±lnie zmieni¢ adres czujnika na magistrali I2C.
Pierwszym krokiem jest ustawienie odpowiedniego pinu GPIO (ang. General Purpose Input/Output) Arduino, podª¡czonego do pinu XSHUT czujnika, w trybie OUTPUT. Nast¦pnie nale»y skorzysta¢ z funkcji setAddress(), aby ustawi¢ odpowiedni adres dla wybranego czujnika. Kolejnym krokiem jest przeª¡czenie stanu pinu Arduino na INPUT oraz odczekanie 10 milisekund.
Wykonanie powy»szej sekwencji gwarantuje poprawn¡ zmian¦ adresu czujnika na magistrali I2C. U»ycie samej funkcji setAddress() bez zastosowania pinu XSHUT nie zmieni adresu czujnika.

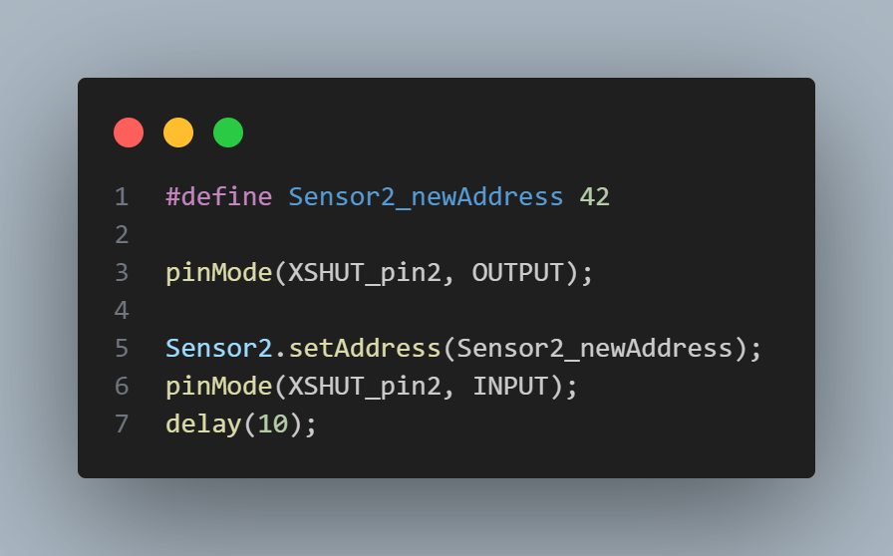
[picture p38: figure]

Rysunek 14: Fragment kodu ¹ródªowego przedstawiaj¡cy sekwencj¦ konieczn¡ do zmiany adresu czujnika

## 2.8. Monta» silników wewn¡trz dolnej komory obudowy

## 2.9. Monta» ogniw wraz z ukªadem BMS oraz podª¡czenie czujników

## 2.10. Integracja czujników z silnikami oraz implementacja logiki sterowania

2.10.1. Slave

Mikrokontroler Arduino UNO 3 skongurowany do pracy typu Slave odbiera paczk¦ danych przez zmienn¡ "rd"wysyªane przez Master.

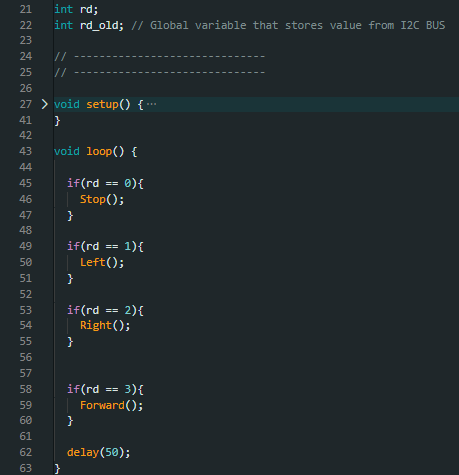
[picture p39: figure]

Rysunek 15: Fragment kodu ¹ródªowego przedstawiaj¡cy odbiór komunikatów przesyªanych przez mikrokontroler Master.

Zgodnie z odbieranym komunikatami o zmianie kierunku indeksowanymi od 0 do 3, program wywoªuje odpowiednie funkcje.

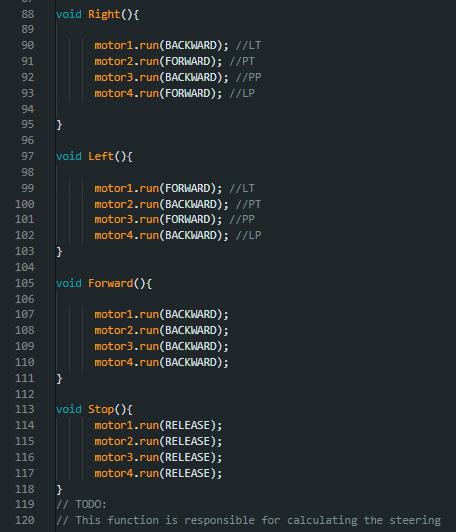
[picture p40: figure]

Rysunek 16: Fragment kodu ¹ródªowego przedstawiaj¡cy implementacj¦ ruchu pojazdu w odpowiednich kierunkach.

Funkcje okre±laj¡ce kierunek jazdy zostaªy skonstruowane wedle logiki i geometrii dziaªania kóª szwedzkich.

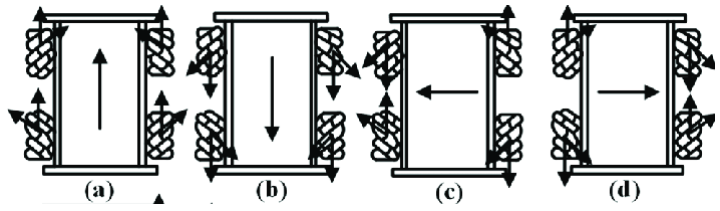
[picture p41: figure]

Rysunek 17: Wizualizacja zale»no±ci kierunku jazdy od obrotu kóª szwedzkich.

## 2.11. Testy poprawno±ci dziaªania algorytmu steruj¡cego

## 3. Napotkane problemy

## 3.1. Poª¡czenie aplikacji z Arduino

## 3.2. Podª¡czenie laserowych czujników odlegªo±ci

## 3.3. Monta» silników oraz kóª

## 4. Podsumowanie
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
