JakubPajak/arduino_robot/report/src/code_snaps/iduino.png

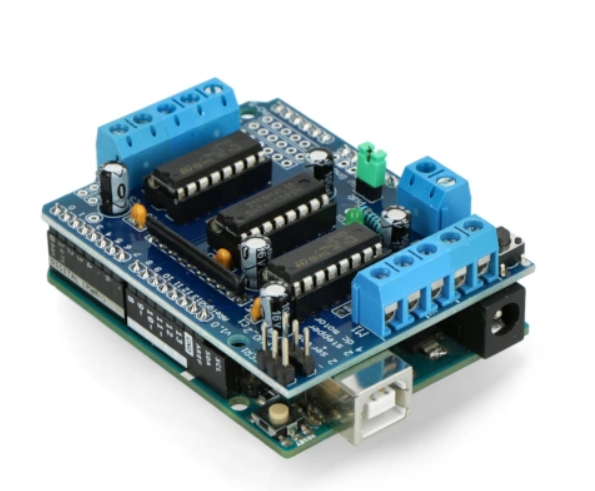
report/src/code_snaps/iduino.png
