JakubPajak/arduino_robot/report/src/Robot_pics/Finished.png

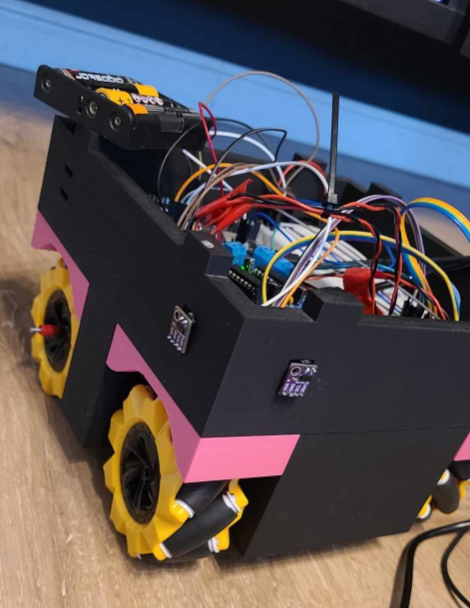
report/src/Robot_pics/Finished.png
