JakubPajak/arduino_robot/report/src/Robot_pics/Fusion 2.png

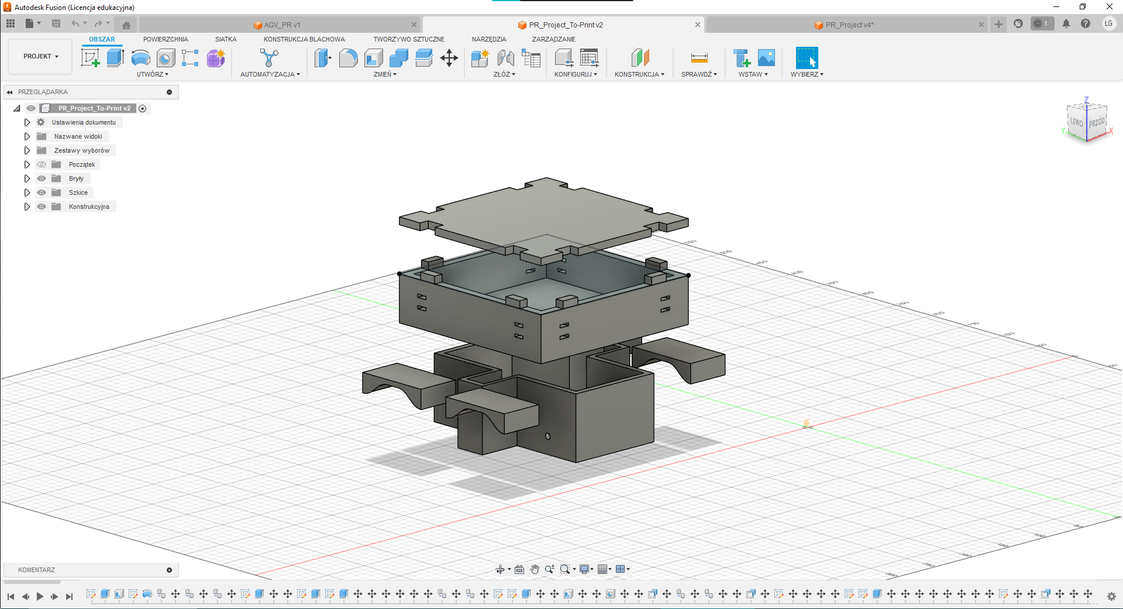
report/src/Robot_pics/Fusion 2.png
