JakubPajak/arduino_robot/report/src/Robot_pics/Fusion 3.png

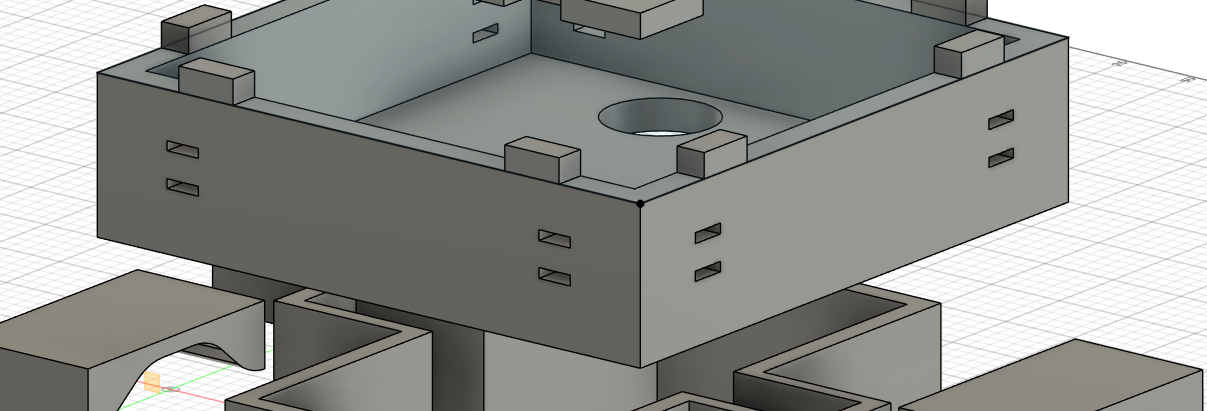
report/src/Robot_pics/Fusion 3.png
