JakubPajak/arduino_robot/report/src/Robot_pics/listwa-kola.jpg

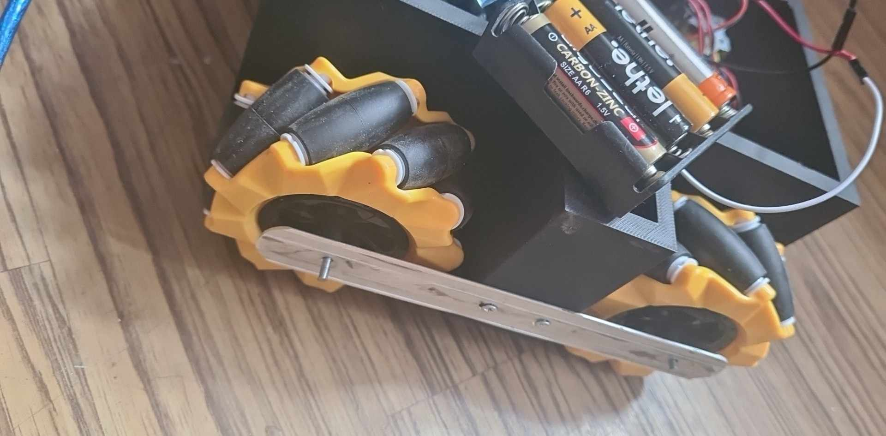
report/src/Robot_pics/listwa-kola.jpg
