JakubPajak/arduino_robot/report/src/Robot_pics/Mecanum.png

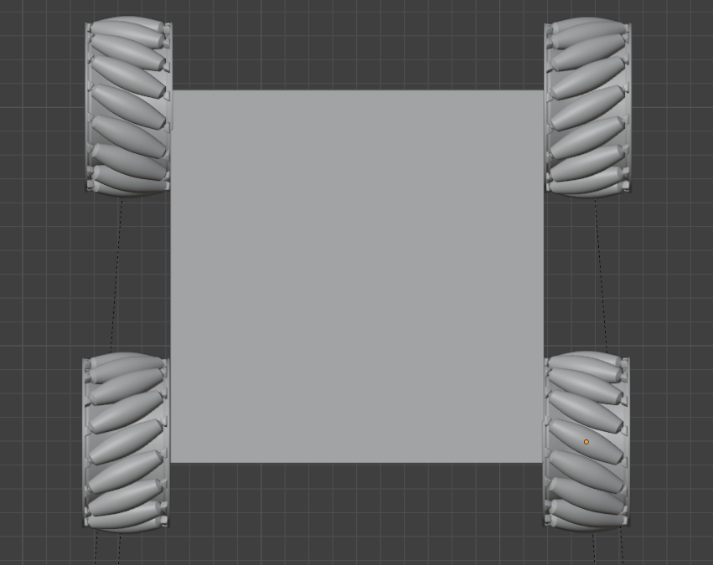
report/src/Robot_pics/Mecanum.png
